bantybanty/ESP8266-Deskop_Power/Project Outputs for ESP8266-Deskop_Power/Verification Report/DiffReport/ESP8266-Deskop_Power.html

Altium

# Differences Report for Project ESP8266-Deskop_Power.PrjPcb and ESP8266-Deskop_Power.PcbDoc

Date: | | 26-12-2024
Time: | | 17:57:14
Filename: | | C:\Users\desktop\Documents\Project Files\Altium\Projects\Project - Devlopment\ESP8266-Deskop_Power\Project Outputs for ESP8266-Deskop_Power\Verification Report\DiffReport\ESP8266-Deskop_Power.html

## Different Descriptions

Schematic Object | PCB Object
MM3Z12VST1G Zener Diode, 12V 2% 200 mW SMT 2-Pin SOD-323 | ON Semiconductor MM3Z12VST1G [ZD1P]

Back to top
