bantybanty/ESP8266-Deskop_Power/Project Outputs for ESP8266-Deskop_Power/Full Documentation/ERC/Electrical Rules Check.PDF

### Electrical Rules Check Report

Class | Document | Message
Warning | 5_Keys_And_Status.SchDoc | Net WS2812B_DATA has no driving source (Pin LED1K-4, Pin R3K-1)
Thursday 26 Dec 2024 6:30:08 PM | Page 1 of 1
