bantybanty/ESP8266-Deskop_Power/screenshot/Screenshot_1.png

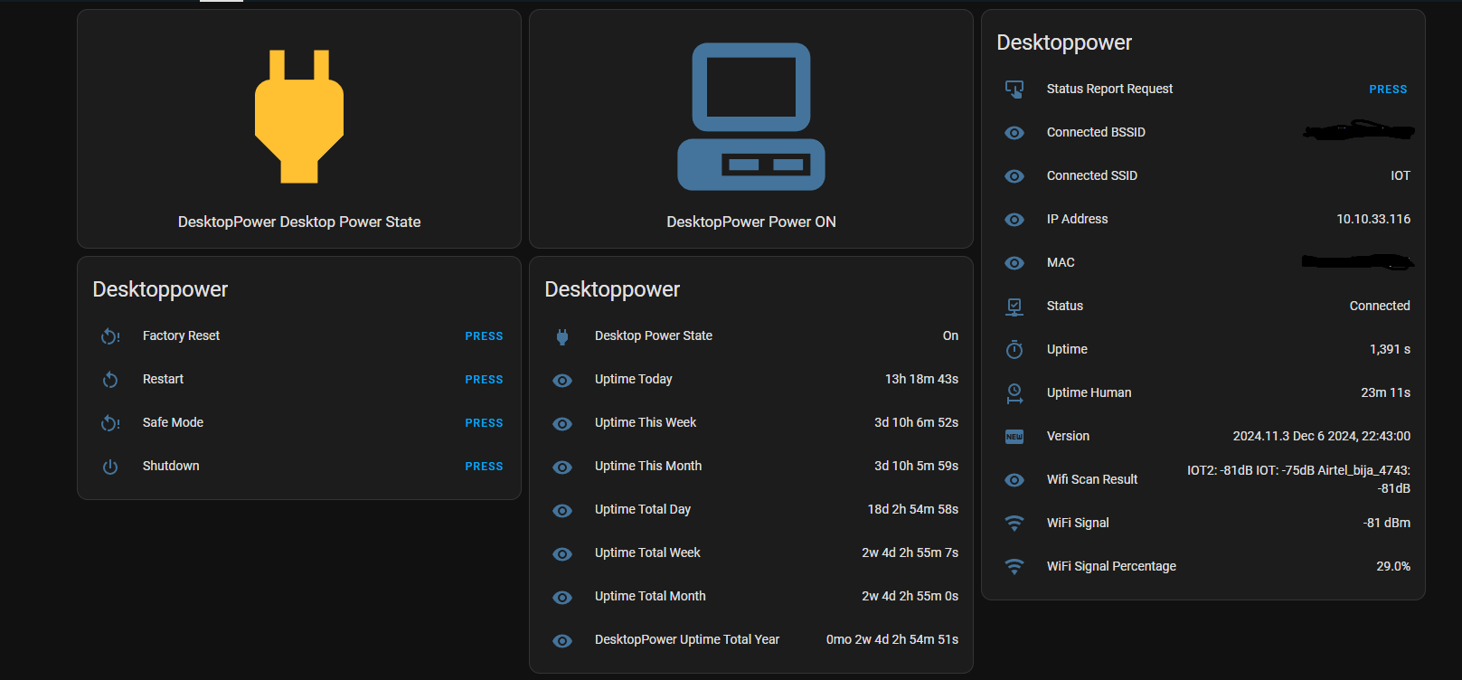
screenshot/Screenshot_1.png
