bantybanty/ESP8266-Deskop_Power/Project Outputs for ESP8266-Deskop_Power/Full Documentation/BOM/Bill of Materials.PDF

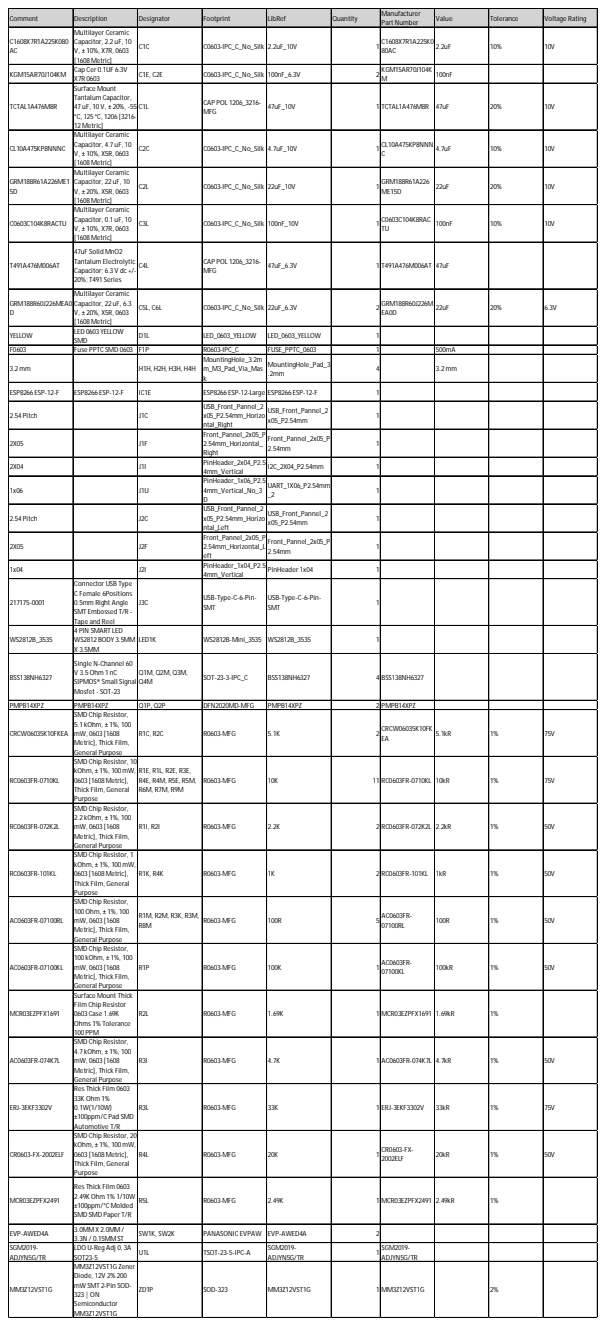
[picture p2: page 1]

Comment | Description | Designator | Footprint | LibRef | Quantity | Manufacturer Part Number | Value | Tolerance | Voltage Rating

C1608X7R1A225K080 AC | Multilayer Ceramic Capacitor, 2.2 uF, 10 V, ± 10%, X7R, 0603 [1608 Metric] | C1C | C0603-IPC_C_No_Silk | 2.2uF_10V | | 1 C1608X7R1A225K0 80AC | 2.2uF | 10% | 10V

KGM15AR70J104KM | Cap Cer 0.1UF 6.3V X7R 0603 | C1E, C2E | C0603-IPC_C_No_Silk | 100nF_6.3V | | 2 KGM15AR70J104K M | 100nF

TCTAL1A476M8R | Surface Mount Tantalum Capacitor, 47 uF, 10 V, ± 20%, -55 °C, 125 °C, 1206 [3216-12 Metric] | C1L | CAP POL 1206_3216-MFG | 47uF_10V | | 1 TCTAL1A476M8R | 47uF | 20% | 10V

CL10A475KP8NNNC | Multilayer Ceramic Capacitor, 4.7 uF, 10 V, ± 10%, X5R, 0603 [1608 Metric] | C2C | C0603-IPC_C_No_Silk | 4.7uF_10V | | 1 CL10A475KP8NNN C | 4.7uF | 10% | 10V

GRM188R61A226ME1 5D | Multilayer Ceramic Capacitor, 22 uF, 10 V, ± 20%, X5R, 0603 [1608 Metric] | C2L | C0603-IPC_C_No_Silk | 22uF_10V | | 1 GRM188R61A226 ME15D | 22uF | 20% | 10V

C0603C104K8RACTU | Multilayer Ceramic Capacitor, 0.1 uF, 10 V, ± 10%, X7R, 0603 [1608 Metric] | C3L | C0603-IPC_C_No_Silk | 100nF_10V | | 1 C0603C104K8RAC TU | 100nF | 10% | 10V

T491A476M006AT | 47uF Solid MnO2 Tantalum Electrolytic Capacitor; 6.3 V dc +/-20%; T491 Series | C4L | CAP POL 1206_3216-MFG | 47uF_6.3V | | 1 T491A476M006AT | 47uF

GRM188R60J226MEA0 D | Multilayer Ceramic Capacitor, 22 uF, 6.3 V, ± 20%, X5R, 0603 [1608 Metric] | C5L, C6L | C0603-IPC_C_No_Silk | 22uF_6.3V | | 2 GRM188R60J226M EA0D | 22uF | 20% | 6.3V

YELLOW | LED 0603 YELLOW SMD | D1L | LED_0603_YELLOW | LED_0603_YELLOW | | 1

F0603 | Fuse PPTC SMD 0603 | F1P | R0603-IPC_C | FUSE_PPTC_0603 | | 1 | 500mA
3.2mm | | H1H, H2H, H3H, H4H | MountingHole_3.2m m_M3_Pad_Via_Mas k | MountingHole_Pad_3 .2mm | | 4 | 3.2mm

ESP8266 ESP-12-F | ESP8266 ESP-12-F | IC1E | ESP8266 ESP-12-Large | ESP8266 ESP-12-F | | 1

2.54 Pitch | | J1C | USB_Front_Pannel_2 x05_P2.54mm_Horizo ntal_Right | USB_Front_Pannel_2 x05_P2.54mm | | 1

2X05 | | J1F | Front_Pannel_2x05_P 2.54mm_Horizontal_ Right | Front_Pannel_2x05_P 2.54mm | | 1

2X04 | | J1I | PinHeader_2x04_P2.5 4mm_Vertical | I2C_2X04_P2.54mm | | 1

1x06 | | J1U | PinHeader_1x06_P2.5 4mm_Vertical_No_3 D | UART_1X06_P2.54mm _2 | | 1

2.54 Pitch | | J2C | USB_Front_Pannel_2 x05_P2.54mm_Horizo ntal_Left | USB_Front_Pannel_2 x05_P2.54mm | | 1

2X05 | | J2F | Front_Pannel_2x05_P 2.54mm_Horizontal_L eft | Front_Pannel_2x05_P 2.54mm | | 1

1x04 | | J2I | PinHeader_1x04_P2.5 4mm_Vertical | PinHeader 1x04 | | 1

217175-0001 | Connector USB Type C Female 6Positions 0.5mm Right Angle SMT Embossed T/R -Tape and Reel | J3C | USB-Type-C-6-Pin-SMT | USB-Type-C-6-Pin-SMT | | 1

WS2812B_3535 | 4 PIN SMART LED WS2812 BODY 3.5MM X 3.5MM | LED1K | WS2812B-Mini_3535 | WS2812B_3535 | | 1

BSS138NH6327 | Single N-Channel 60 V 3.5Ohm 1 nC SIPMOS® Small Signal Mosfet - SOT-23 | Q1M, Q2M, Q3M, Q4M | SOT-23-3-IPC_C | BSS138NH6327 | | 4 BSS138NH6327

PMPB14XPZ | PMPB14XPZ | Q1P, Q2P | DFN2020MD-MFG | PMPB14XPZ | | 2 PMPB14XPZ
CRCW06035K10FKEA | SMD Chip Resistor, 5.1 kOhm, ± 1%, 100 mW, 0603 [1608 Metric], Thick Film, General Purpose | R1C, R2C | R0603-MFG | 5.1K | | 2 CRCW06035K10FK EA | 5.1kR | 1% | 75V

RC0603FR-0710KL | SMD Chip Resistor, 10 kOhm, ± 1%, 100mW, 0603 [1608 Metric], Thick Film, General Purpose | R1E, R1L, R2E, R3E, R4E, R4M, R5E, R5M, R6M, R7M, R9M | R0603-MFG | 10K | 11 RC0603FR-0710KL | | 10kR | 1% | 75V

RC0603FR-072K2L | SMD Chip Resistor, 2.2 kOhm, ± 1%, 100 mW, 0603 [1608 Metric], Thick Film, General Purpose | R1I, R2I | R0603-MFG | 2.2K | | 2 RC0603FR-072K2L | 2.2kR | 1% | 50V

RC0603FR-101KL | SMD Chip Resistor, 1 kOhm, ± 1%, 100mW, 0603 [1608 Metric], Thick Film, General Purpose | R1K, R4K | R0603-MFG | 1K | | 2 RC0603FR-101KL | 1kR | 1% | 50V

AC0603FR-07100RL | SMD Chip Resistor, 100Ohm, ± 1%, 100 mW, 0603 [1608 Metric], Thick Film, General Purpose | R1M, R2M, R3K, R3M, R8M | R0603-MFG | 100R | | 5 AC0603FR-07100RL | 100R | 1% | 50V

AC0603FR-07100KL | SMD Chip Resistor, 100 kOhm, ± 1%, 100 mW, 0603 [1608 Metric], Thick Film, General Purpose | R1P | R0603-MFG | 100K | | 1 AC0603FR-07100KL | 100kR | 1% | 50V

MCR03EZPFX1691 | Surface Mount Thick Film Chip Resistor 0603 Case 1.69K Ohms 1% Tolerance 100 PPM | R2L | R0603-MFG | 1.69K | | 1 MCR03EZPFX1691 | 1.69kR | 1%

AC0603FR-074K7L | SMD Chip Resistor, 4.7 kOhm, ± 1%, 100 mW, 0603 [1608 Metric], Thick Film, General Purpose | R3I | R0603-MFG | 4.7K | | 1 AC0603FR-074K7L | 4.7kR | 1% | 50V

ERJ-3EKF3302V | Res Thick Film 0603 33K Ohm 1% 0.1W(1/10W) ±100ppm/C Pad SMD Automotive T/R | R3L | R0603-MFG | 33K | | 1 ERJ-3EKF3302V | 33kR | 1% | 75V

CR0603-FX-2002ELF | SMD Chip Resistor, 20 kOhm, ± 1%, 100mW, 0603 [1608 Metric], Thick Film, General Purpose | R4L | R0603-MFG | 20K | | 1 CR0603-FX-2002ELF | 20kR | 1% | 50V

MCR03EZPFX2491 | Res Thick Film 0603 2.49K Ohm 1% 1/10W ±100ppm/°C Molded SMD SMD Paper T/R | R5L | R0603-MFG | 2.49K | | 1 MCR03EZPFX2491 | 2.49kR | 1%

EVP-AWED4A | 3.0MM X 2.0MM / 3.3N / 0.15MM ST | SW1K, SW2K | PANASONIC EVPAW | EVP-AWED4A | | 2

SGM2019-ADJYN5G/TR | LDO U-Reg Adj 0, 3A SOT23-5 | U1L | TSOT-23-5-IPC-A | SGM2019-ADJYN5G/TR | | 1 SGM2019-ADJYN5G/TR

MM3Z12VST1G | MM3Z12VST1G Zener Diode, 12V 2% 200 mW SMT 2-Pin SOD-323 | ON Semiconductor MM3Z12VST1G | ZD1P | SOD-323 | MM3Z12VST1G | | 1 MM3Z12VST1G | | 2%
