bantybanty/ESP8266-Deskop_Power/Project Outputs for ESP8266-Deskop_Power/Verification Report/ReportComponents/Component Cross Reference Report-ESP8266-Deskop_Power.xlsx

Comment | Description | Designator | Footprint | LibRef | Quantity
F0603, PMPB14XPZ, AC0603FR-07100KL, MM3Z12VST1G | Fuse PPTC SMD 0603, PMPB14XPZ, SMD Chip Resistor, 100 kOhm, ± 1%, 100 mW, 0603 [1608 Metric], Thick Film, General Purpose, MM3Z12VST1G Zener Diode, 12V 2% 200 mW SMT 2-Pin SOD-323 | ON Semiconductor MM3Z12VST1G | F1P, Q1P, Q2P, R1P, ZD1P | R0603-IPC_C, DFN2020MD-MFG, R0603-MFG, SOD-323 | FUSE_PPTC_0603, PMPB14XPZ, 100K, MM3Z12VST1G | 5
TCTAL1A476M8R, GRM188R61A226ME15D, C0603C104K8RACTU, T491A476M006AT, GRM188R60J226MEA0D, YELLOW, RC0603FR-0710KL, MCR03EZPFX1691, ERJ-3EKF3302V, CR0603-FX-2002ELF, MCR03EZPFX2491, SGM2019-ADJYN5G/TR | Surface Mount Tantalum Capacitor, 47 uF, 10 V, ± 20%, -55 °C, 125 °C, 1206 [3216-12 Metric], Multilayer Ceramic Capacitor, 22 uF, 10 V, ± 20%, X5R, 0603 [1608 Metric], Multilayer Ceramic Capacitor, 0.1 uF, 10 V, ± 10%, X7R, 0603 [1608 Metric], 47uF Solid MnO2 Tantalum Electrolytic Capacitor; 6.3 V dc +/-20%; T491 Series, Multilayer Ceramic Capacitor, 22 uF, 6.3 V, ± 20%, X5R, 0603 [1608 Metric], LED 0603 YELLOW SMD, SMD Chip Resistor, 10 kOhm, ± 1%, 100 mW, 0603 [1608 Metric], Thick Film, General Purpose, Surface Mount Thick Film Chip Resistor 0603 Case 1.69K Ohms 1% Tolerance 100 PPM, Res Thick Film 0603 33K Ohm 1% 0.1W(1/10W) ±100ppm/C Pad SMD Automotive T/R, SMD Chip Resistor, 20 kOhm, ± 1%, 100 mW, 0603 [1608 Metric], Thick Film, General Purpose, Res Thick Film 0603 2.49K Ohm 1% 1/10W ±100ppm/°C Molded SMD SMD Paper T/R, LDO U-Reg Adj 0, 3A SOT23-5 | C1L, C2L, C3L, C4L, C5L, C6L, D1L, R1L, R2L, R3L, R4L, R5L, U1L | CAP POL 1206_3216-MFG, C0603-IPC_C_No_Silk, LED_0603_YELLOW, R0603-MFG, TSOT-23-5-IPC-A | 47uF_10V, 22uF_10V, 100nF_10V, 47uF_6.3V, 22uF_6.3V, LED_0603_YELLOW, 10K, 1.69K, 33K, 20K, 2.49K, SGM2019-ADJYN5G/TR | 13
KGM15AR70J104KM, ESP8266 ESP-12-F, RC0603FR-0710KL | Cap Cer 0.1UF 6.3V X7R 0603, ESP8266 ESP-12-F, SMD Chip Resistor, 10 kOhm, ± 1%, 100 mW, 0603 [1608 Metric], Thick Film, General Purpose | C1E, C2E, IC1E, R1E, R2E, R3E, R4E, R5E | C0603-IPC_C_No_Silk, ESP8266 ESP-12-Large, R0603-MFG | 100nF_6.3V, ESP8266 ESP-12-F, 10K | 8
1x06 |  | J1U | PinHeader_1x06_P2.54mm_Vertical_No_3D | UART_1X06_P2.54mm_2 | 1
WS2812B_3535, RC0603FR-101KL, AC0603FR-07100RL, EVP-AWED4A | 4 PIN SMART LED WS2812 BODY 3.5MM X 3.5MM, SMD Chip Resistor, 1 kOhm, ± 1%, 100 mW, 0603 [1608 Metric], Thick Film, General Purpose, SMD Chip Resistor, 100 Ohm, ± 1%, 100 mW, 0603 [1608 Metric], Thick Film, General Purpose, 3.0MM X 2.0MM / 3.3N / 0.15MM ST | LED1K, R1K, R3K, R4K, SW1K, SW2K | WS2812B-Mini_3535, R0603-MFG, PANASONIC EVPAW | WS2812B_3535, 1K, 100R, EVP-AWED4A | 6
2X04, 1x04, RC0603FR-072K2L, AC0603FR-074K7L | [NoValue], SMD Chip Resistor, 2.2 kOhm, ± 1%, 100 mW, 0603 [1608 Metric], Thick Film, General Purpose, SMD Chip Resistor, 4.7 kOhm, ± 1%, 100 mW, 0603 [1608 Metric], Thick Film, General Purpose | J1I, J2I, R1I, R2I, R3I | PinHeader_2x04_P2.54mm_Vertical, PinHeader_1x04_P2.54mm_Vertical, R0603-MFG | I2C_2X04_P2.54mm, PinHeader 1x04, 2.2K, 4.7K | 5
BSS138NH6327, AC0603FR-07100RL, RC0603FR-0710KL | Single N-Channel 60 V 3.5 Ohm 1 nC SIPMOS® Small Signal Mosfet - SOT-23, SMD Chip Resistor, 100 Ohm, ± 1%, 100 mW, 0603 [1608 Metric], Thick Film, General Purpose, SMD Chip Resistor, 10 kOhm, ± 1%, 100 mW, 0603 [1608 Metric], Thick Film, General Purpose | Q1M, Q2M, Q3M, Q4M, R1M, R2M, R3M, R4M, R5M, R6M, R7M, R8M, R9M | SOT-23-3-IPC_C, R0603-MFG | BSS138NH6327, 100R, 10K | 13
2X05 |  | J1F, J2F | Front_Pannel_2x05_P2.54mm_Horizontal_Right, Front_Pannel_2x05_P2.54mm_Horizontal_Left | Front_Pannel_2x05_P2.54mm | 2
C1608X7R1A225K080AC, CL10A475KP8NNNC, 2.54 Pitch, 217175-0001, CRCW06035K10FKEA | Multilayer Ceramic Capacitor, 2.2 uF, 10 V, ± 10%, X7R, 0603 [1608 Metric], Multilayer Ceramic Capacitor, 4.7 uF, 10 V, ± 10%, X5R, 0603 [1608 Metric], [NoValue], Connector USB Type C Female 6Positions 0.5mm Right Angle SMT Embossed T/R - Tape and Reel, SMD Chip Resistor, 5.1 kOhm, ± 1%, 100 mW, 0603 [1608 Metric], Thick Film, General Purpose | C1C, C2C, J1C, J2C, J3C, R1C, R2C | C0603-IPC_C_No_Silk, USB_Front_Pannel_2x05_P2.54mm_Horizontal_Right, USB_Front_Pannel_2x05_P2.54mm_Horizontal_Left, USB-Type-C-6-Pin-SMT, R0603-MFG | 2.2uF_10V, 4.7uF_10V, USB_Front_Pannel_2x05_P2.54mm, USB-Type-C-6-Pin-SMT, 5.1K | 7
3.2 mm |  | H1H, H2H, H3H, H4H | MountingHole_3.2mm_M3_Pad_Via_Mask | MountingHole_Pad_3.2mm | 4
