bantybanty/ESP8266-Deskop_Power/Project Outputs for ESP8266-Deskop_Power/Full Documentation/PCBDrawing/Assembly Drawing.PDF

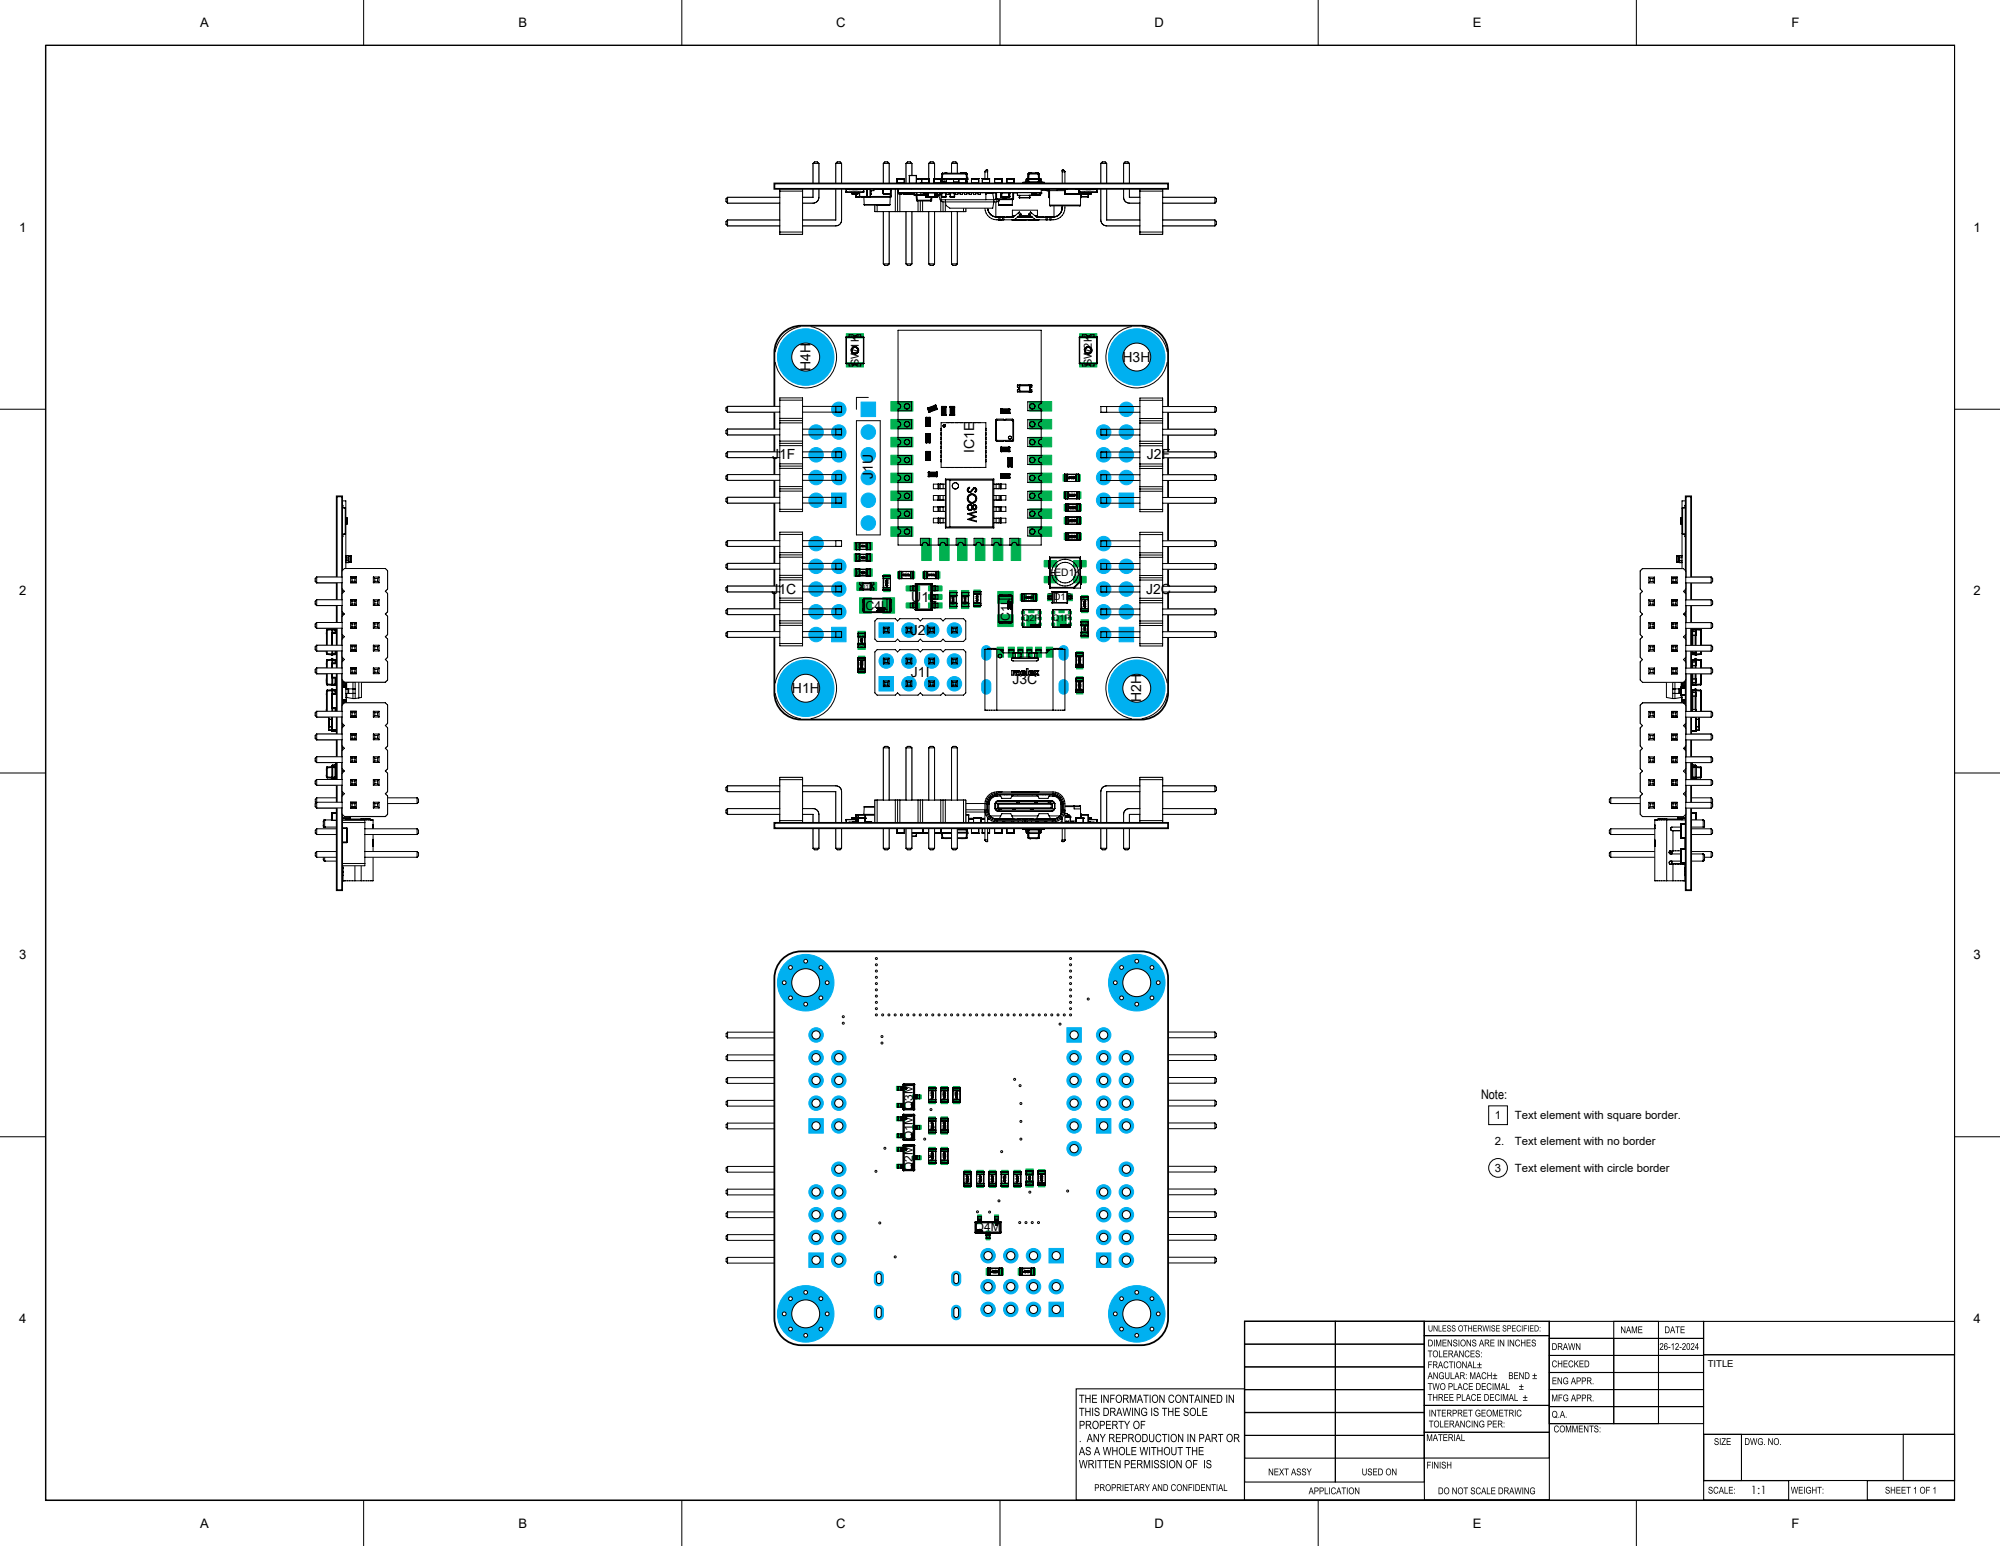
[picture p3: page 1]

Note:
1 Text element with square border.

2. Text element with no border

3 Text element with circle border

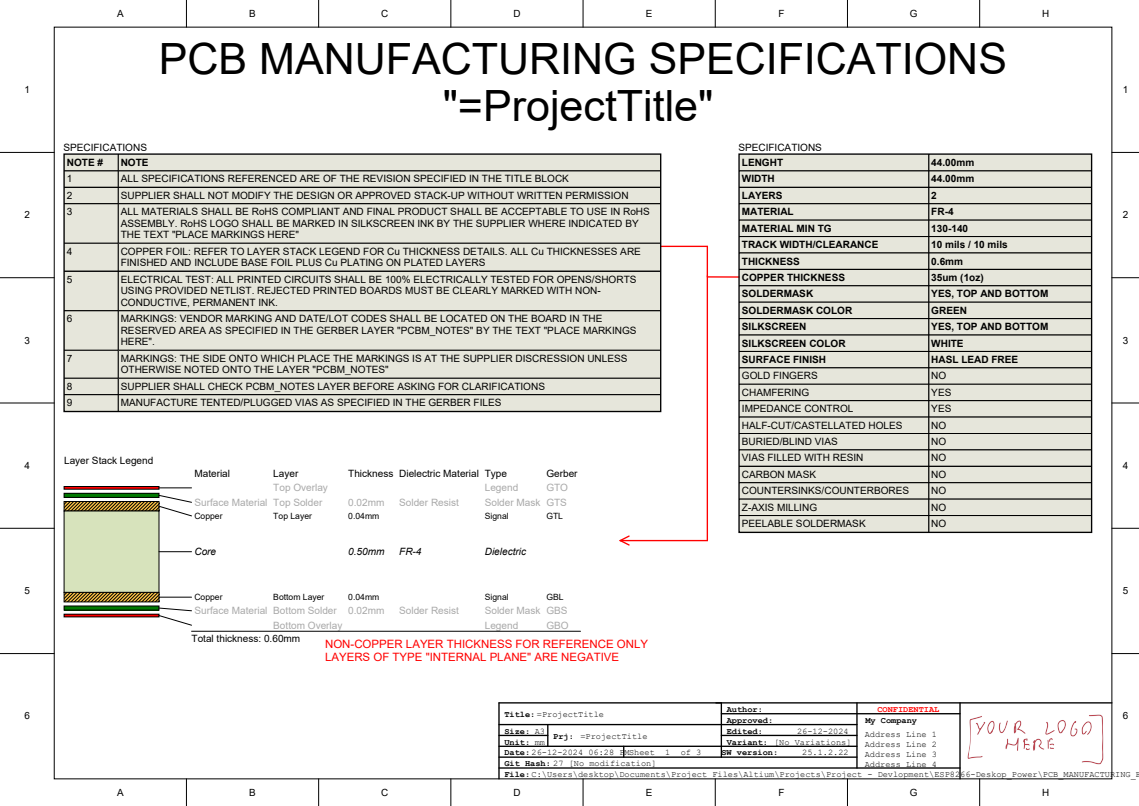
[picture p4: page 2]

NOTE
ALL SPECIFICATIONS REFERENCED ARE OF THE REVISION SPECIFIED IN THE TITLE BLOCK
SUPPLIER SHALL NOT MODIFY THE DESIGN OR APPROVED STACK-UP WITHOUT WRITTEN PERMISSION
ALL MATERIALS SHALL BE RoHS COMPLIANT AND FINAL PRODUCT SHALL BE ACCEPTABLE TO USE IN RoHS
ASSEMBLY. RoHS LOGO SHALL BE MARKED IN SILKSCREEN INK BY THE SUPPLIER WHERE INDICATED BY
THE TEXT "PLACE MARKINGS HERE"

MATERIAL MIN TG | 130-140
TRACK WIDTH/CLEARANCE | 10 mils / 10 mils
THICKNESS | 0.6mm

4 | COPPER FOIL: REFER TO LAYER STACK LEGEND FOR Cu THICKNESS DETAILS. ALL Cu THICKNESSES ARE FINISHED AND INCLUDE BASE FOIL PLUS Cu PLATING ON PLATED LAYERS

ELECTRICAL TEST: ALL PRINTED CIRCUITS SHALL BE 100% ELECTRICALLY TESTED FOR OPENS/SHORTS
USING PROVIDED NETLIST. REJECTED PRINTED BOARDS MUST BE CLEARLY MARKED WITH NON-
CONDUCTIVE, PERMANENT INK.

SOLDERMASK | YES, TOP AND BOTTOM
SOLDERMASK COLOR | GREEN
SILKSCREEN | YES, TOP AND BOTTOM
SILKSCREEN COLOR | WHITE

6 | MARKINGS: VENDOR MARKING AND DATE/LOT CODES SHALL BE LOCATED ON THE BOARD IN THE RESERVED AREA AS SPECIFIED IN THE GERBER LAYER "PCBM_NOTES" BY THE TEXT "PLACE MARKINGS HERE".

MARKINGS: THE SIDE ONTO WHICH PLACE THE MARKINGS IS AT THE SUPPLIER DISCRESSION UNLESS
OTHERWISE NOTED ONTO THE LAYER "PCBM_NOTES"

GOLD FINGERS | NO
CHAMFERING | YES
IMPEDANCE CONTROL | YES
HALF-CUT/CASTELLATED HOLES | NO
BURIED/BLIND VIAS | NO
VIAS FILLED WITH RESIN | NO
CARBON MASK | NO
COUNTERSINKS/COUNTERBORES | NO
Z-AXIS MILLING | NO
PEELABLE SOLDERMASK | NO

8 | SUPPLIER SHALL CHECK PCBM_NOTES LAYER BEFORE ASKING FOR CLARIFICATIONS
9 | MANUFACTURE TENTED/PLUGGED VIAS AS SPECIFIED IN THE GERBER FILES

NON-COPPER LAYER THICKNESS FOR REFERENCE ONLY
LAYERS OF TYPE "INTERNAL PLANE" ARE NEGATIVE

Approved: | My Company Address Line 1 Address Line 2

Size: A3 | Prj: =ProjectTitle | Edited: 26-12-2024
Unit: mm | | Variant: [No Variations]
Date:26-12-2024 06:28 PM | Sheet 1 of 3 | SW version: 25.1.2.22

Git Hash: 27 [No modification]
File:C:\Users\desktop\Documents\Project Files\Altium\Projects\Project - Devlopment\ESP8266-Deskop_Power\PCB_MANUFACTURING_ESP8266-Deskop_Power.PCBDwf

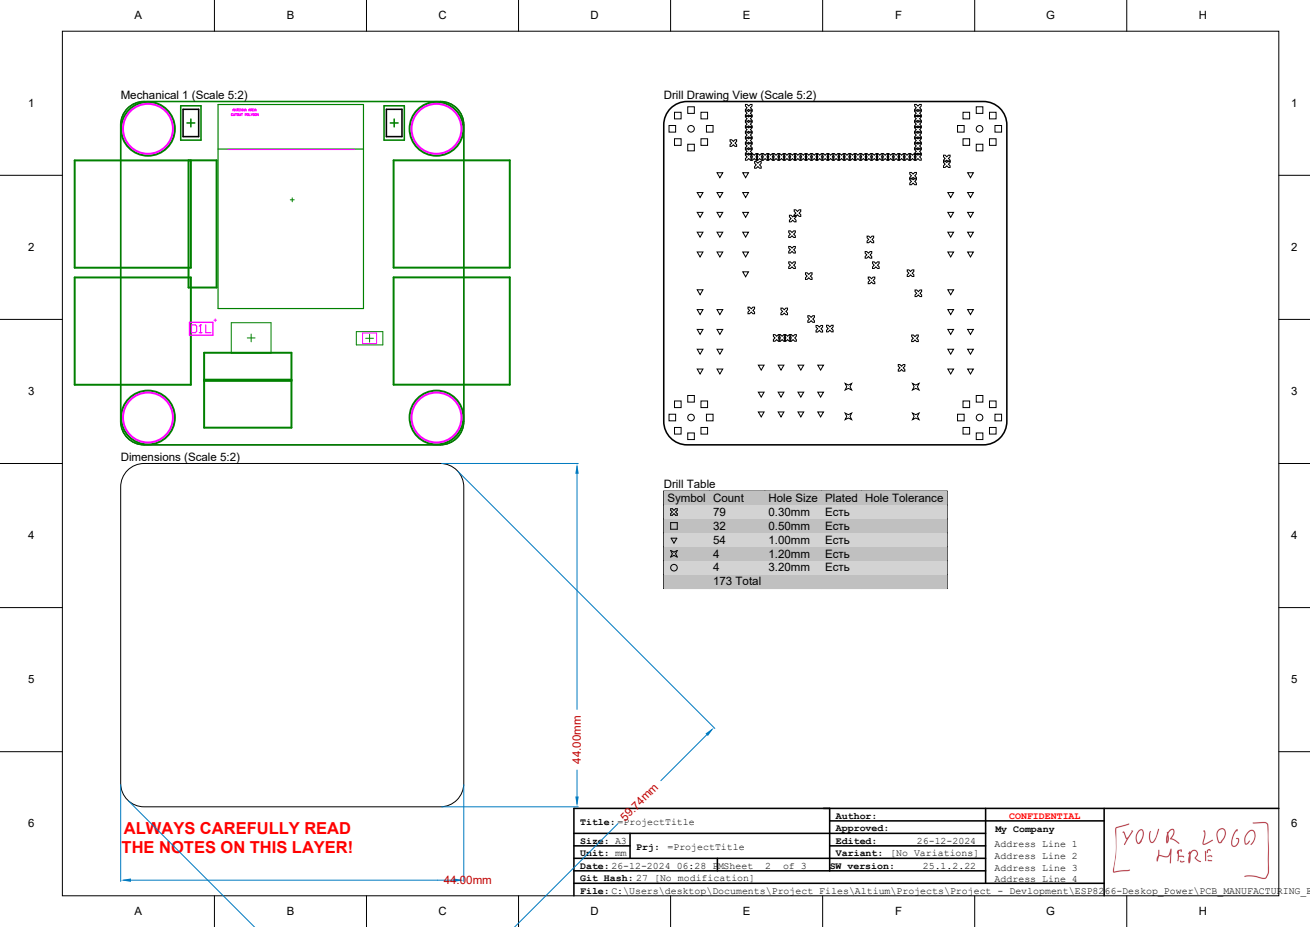
[picture p5: page 3]

Symbol | Count | Hole Size | Plated | Hole Tolerance

79 | 0.30mm | Есть
32 | 0.50mm | Есть
54 | 1.00mm | Есть
4 | 1.20mm | Есть
4 | 3.20mm | Есть
173 Total

ALWAYS CAREFULLY READ
THE NOTES ON THIS LAYER!

Approved: | My Company Address Line 1

Size: A3 | Prj: =ProjectTitle | Edited: 26-12-2024

File:C:\Users\desktop\Documents\Project Files\Altium\Projects\Project - Devlopment\ESP8266-Deskop_Power\PCB_MANUFACTURING_ESP8266-Deskop_Power.PCBDwf

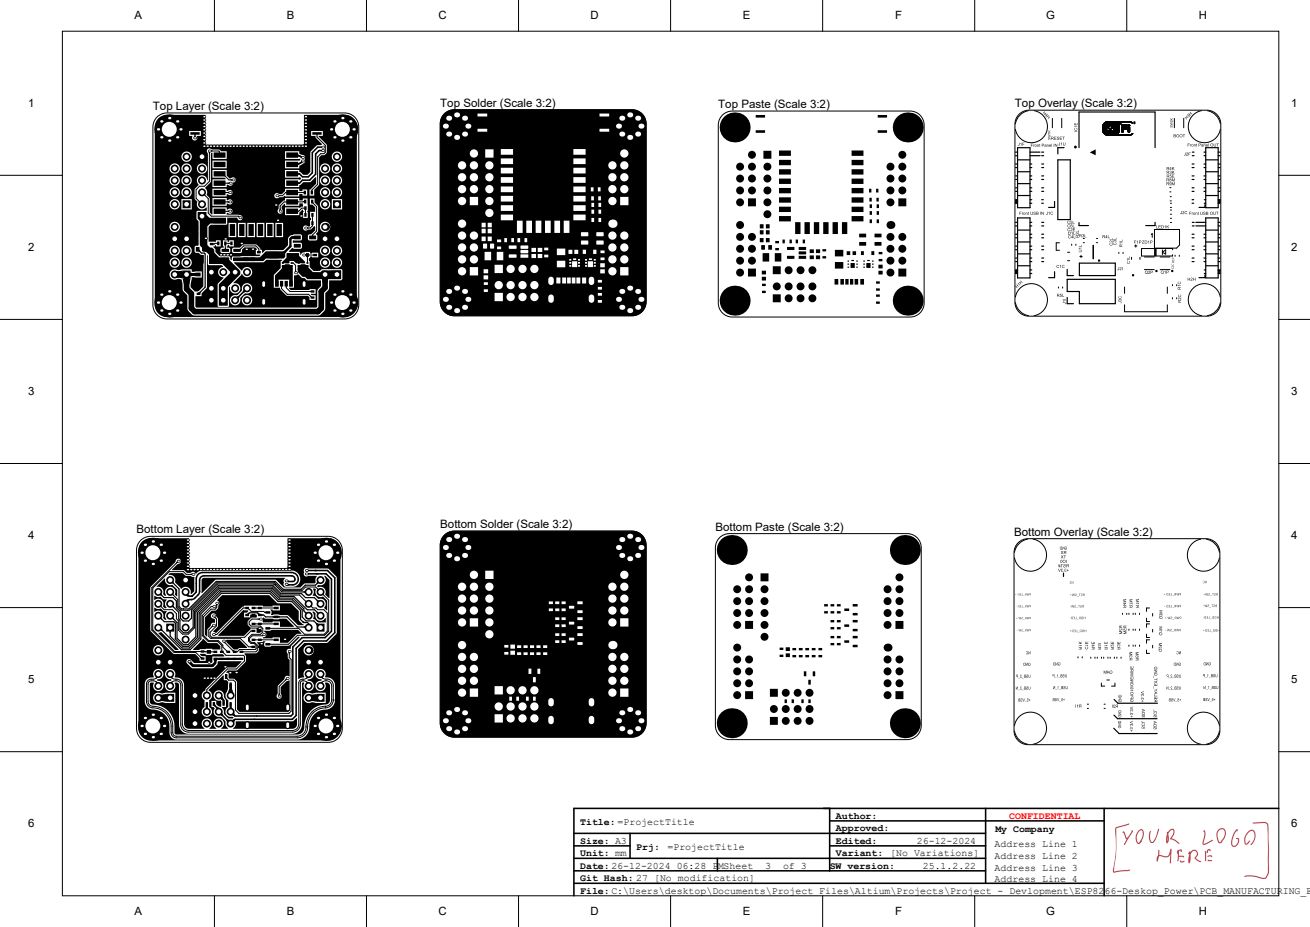
[picture p6: page 4]

File:C:\Users\desktop\Documents\Project Files\Altium\Projects\Project - Devlopment\ESP8266-Deskop_Power\PCB_MANUFACTURING_ESP8266-Deskop_Power.PCBDwf

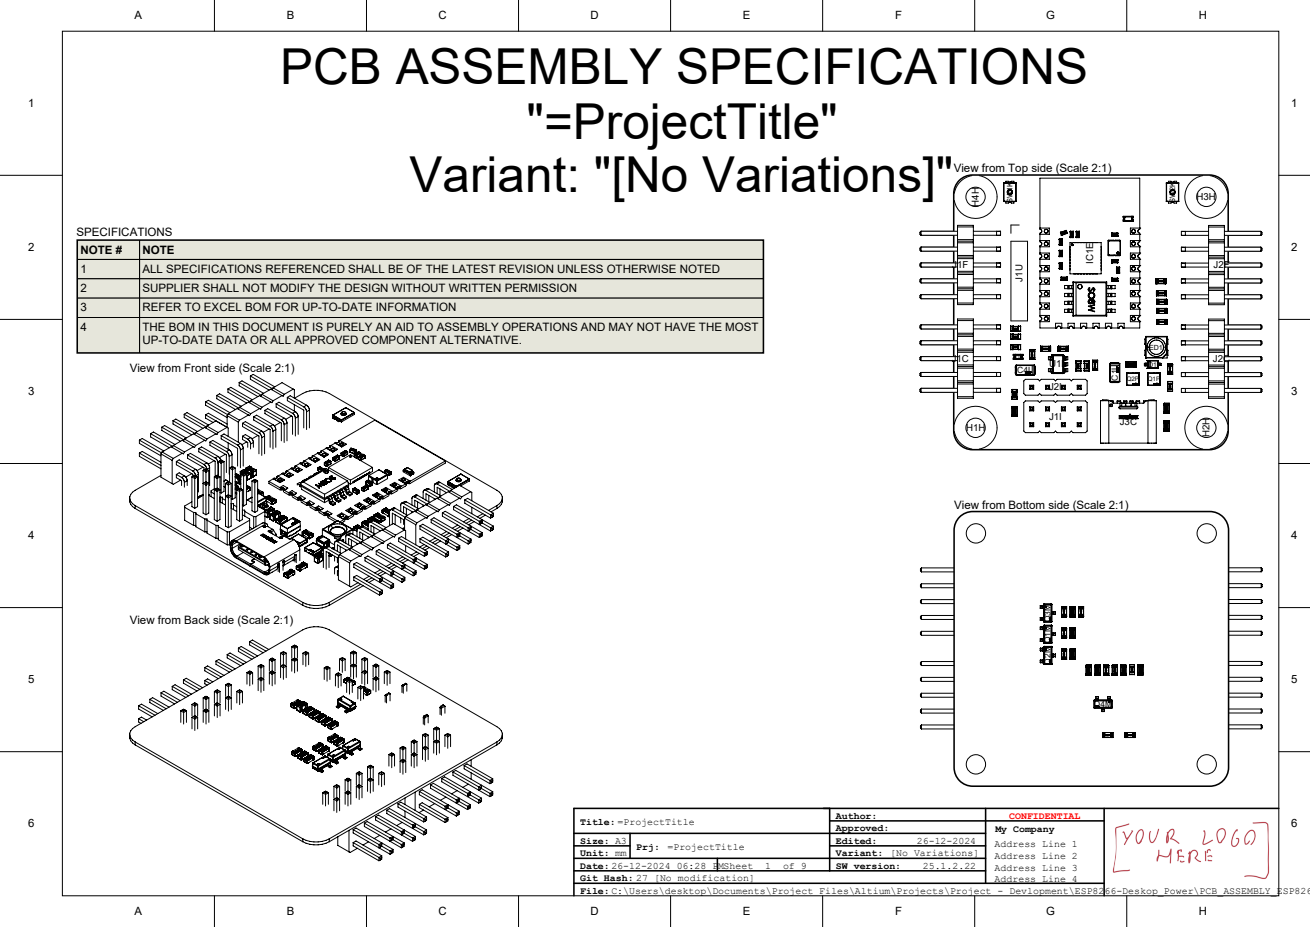
[picture p7: page 5]

View from Top side (Scale 2:1)

NOTE # | NOTE
1 | ALL SPECIFICATIONS REFERENCED SHALL BE OF THE LATEST REVISION UNLESS OTHERWISE NOTED

SUPPLIER SHALL NOT MODIFY THE DESIGN WITHOUT WRITTEN PERMISSION
REFER TO EXCEL BOM FOR UP-TO-DATE INFORMATION
THE BOM IN THIS DOCUMENT IS PURELY AN AID TO ASSEMBLY OPERATIONS AND MAY NOT HAVE THE MOST
UP-TO-DATE DATA OR ALL APPROVED COMPONENT ALTERNATIVE.

View from Front side (Scale 2:1)

View from Bottom side (Scale 2:1)

View from Back side (Scale 2:1)

Approved: | My Company Address Line 1

Size: A3 | Prj: =ProjectTitle | Edited: 26-12-2024

File:C:\Users\desktop\Documents\Project Files\Altium\Projects\Project - Devlopment\ESP8266-Deskop_Power\PCB_ASSEMBLY_ESP8266-Deskop_Power.PCBDwf

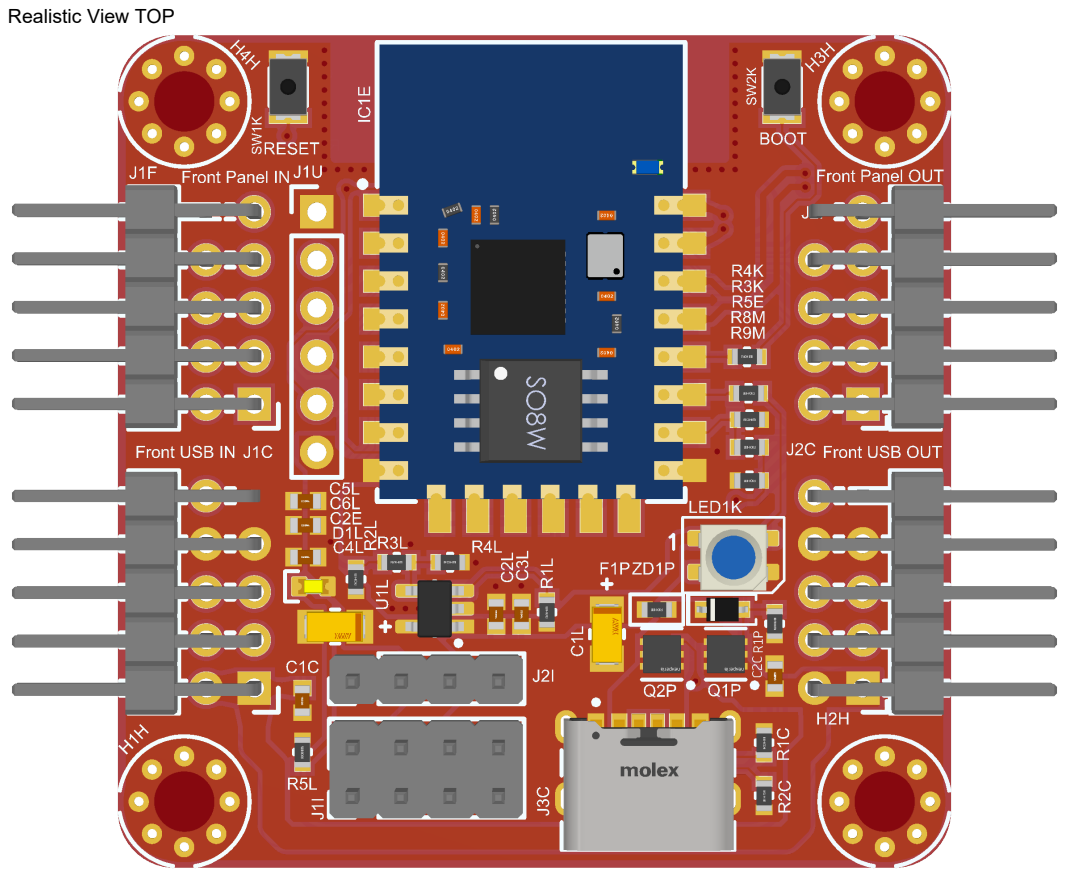
[picture p8: page 6]

Approved: | My Company Address Line 1

Size: A3 | Prj: =ProjectTitle | Edited: 26-12-2024

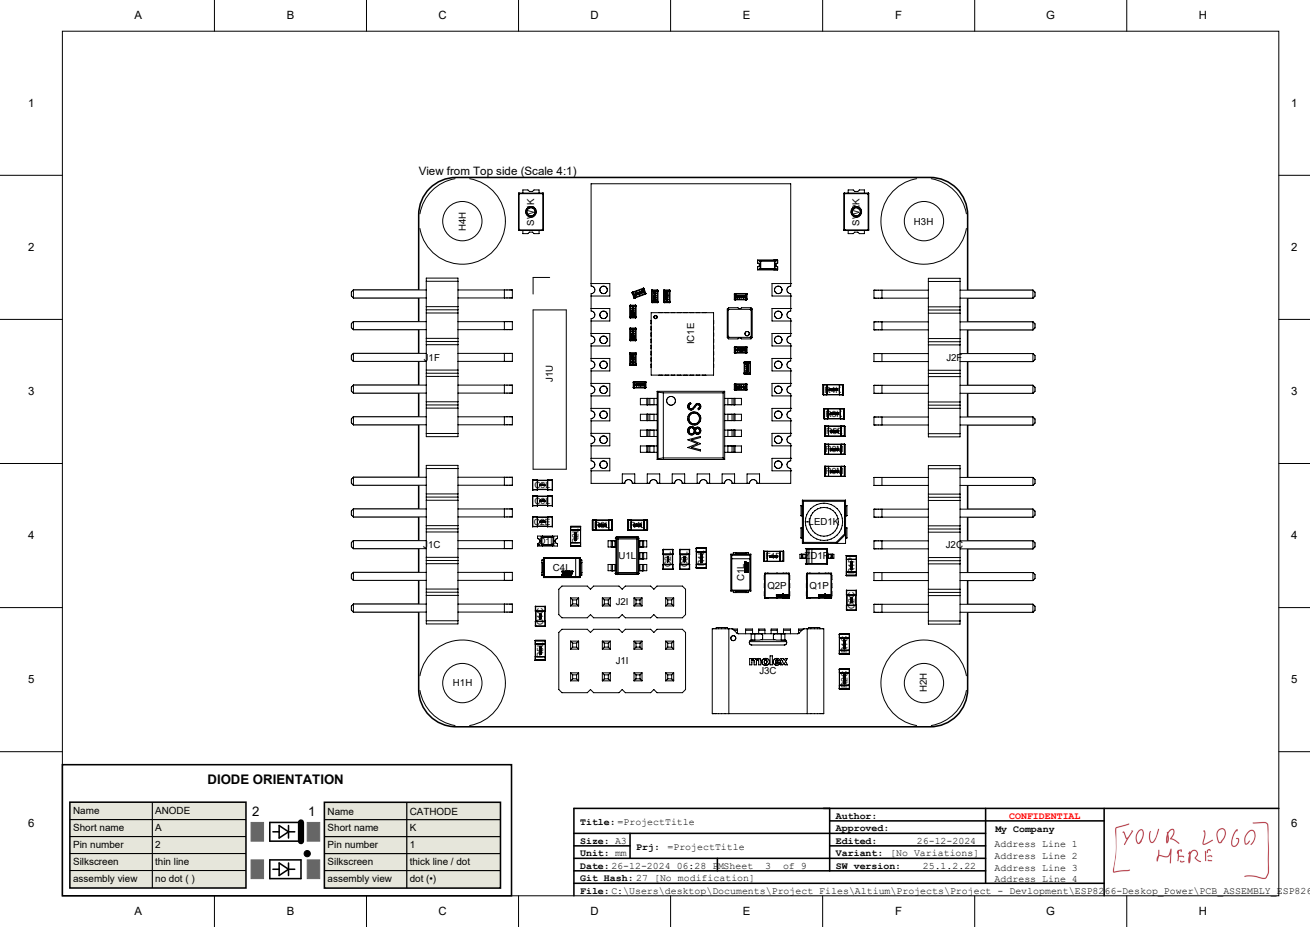
[picture p9: page 7]

View from Top side (Scale 4:1)

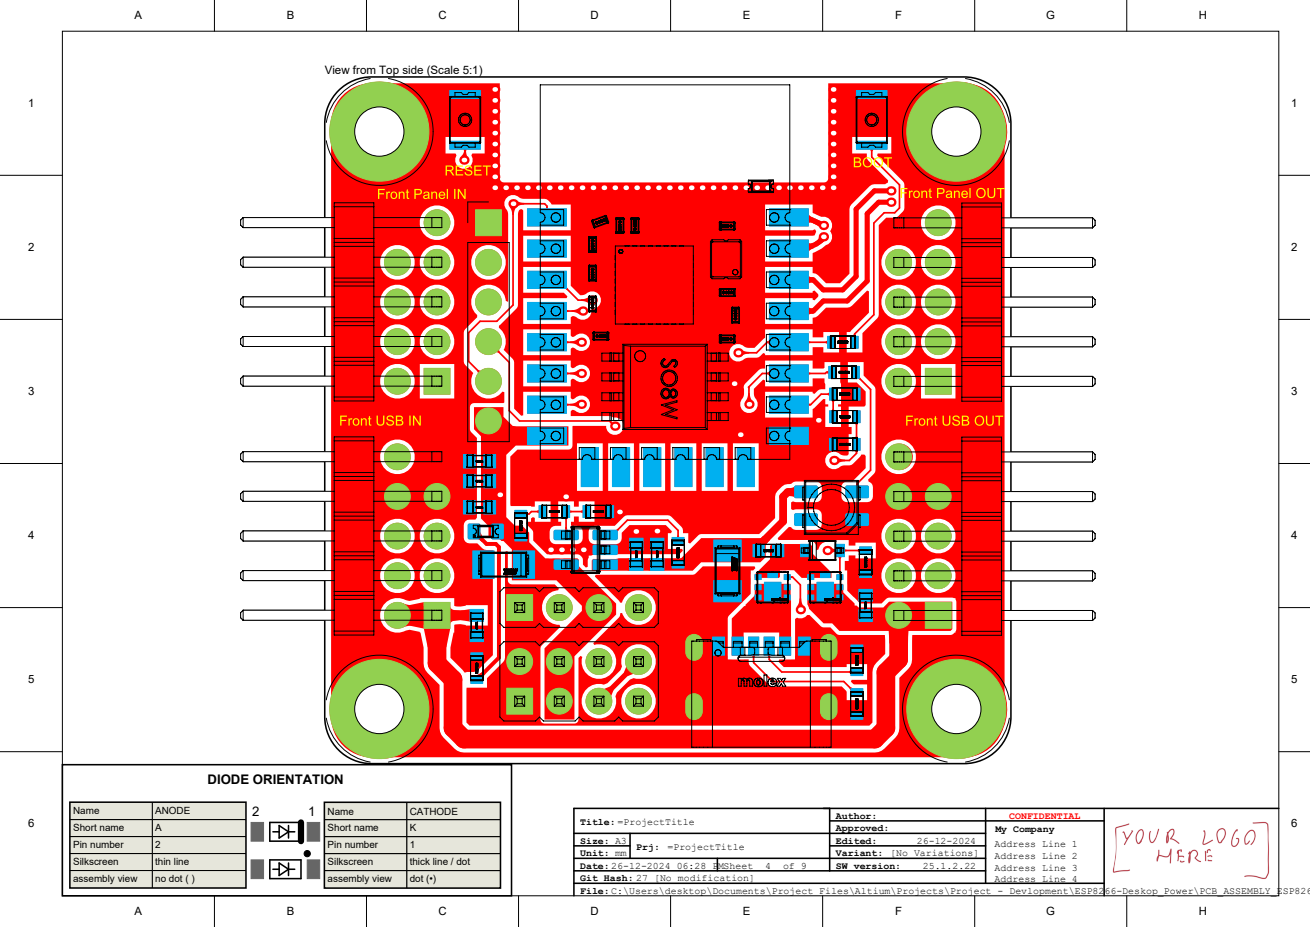
[picture p10: page 8]

View from Top side (Scale 5:1)

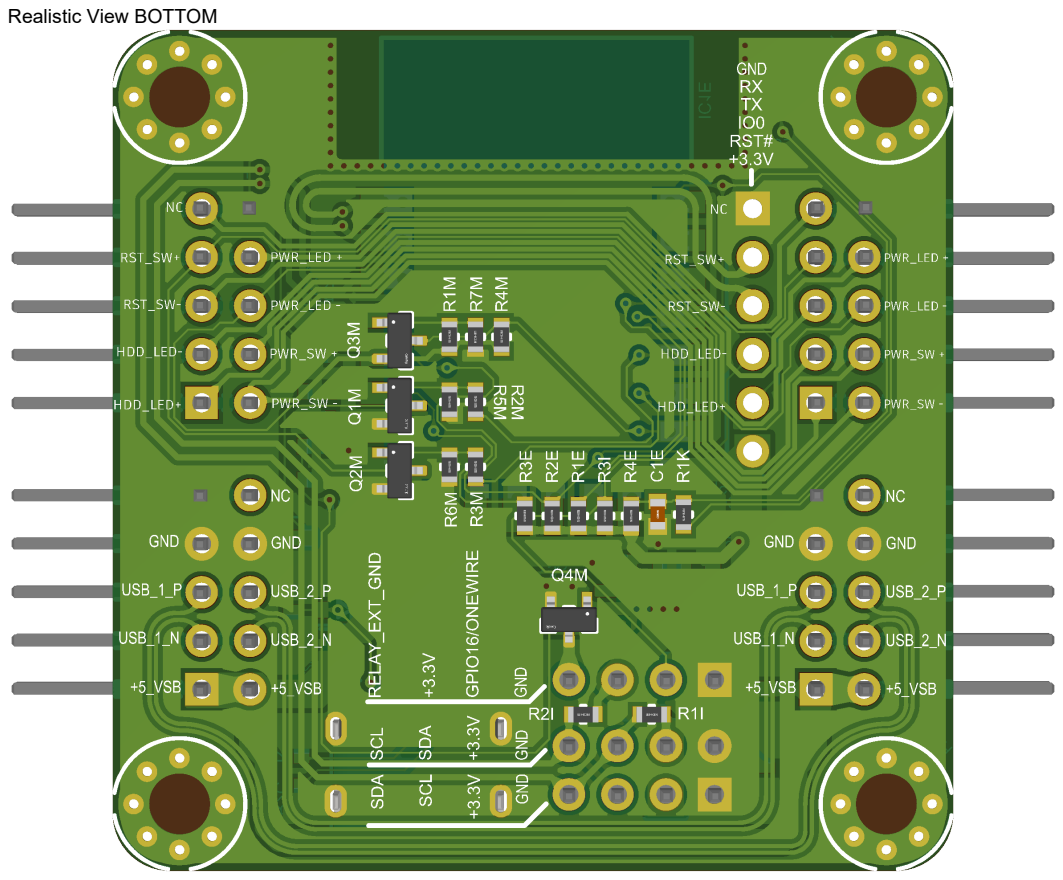
[picture p11: page 9]

Approved: | My Company Address Line 1

Size: A3 | Prj: =ProjectTitle | Edited: 26-12-2024

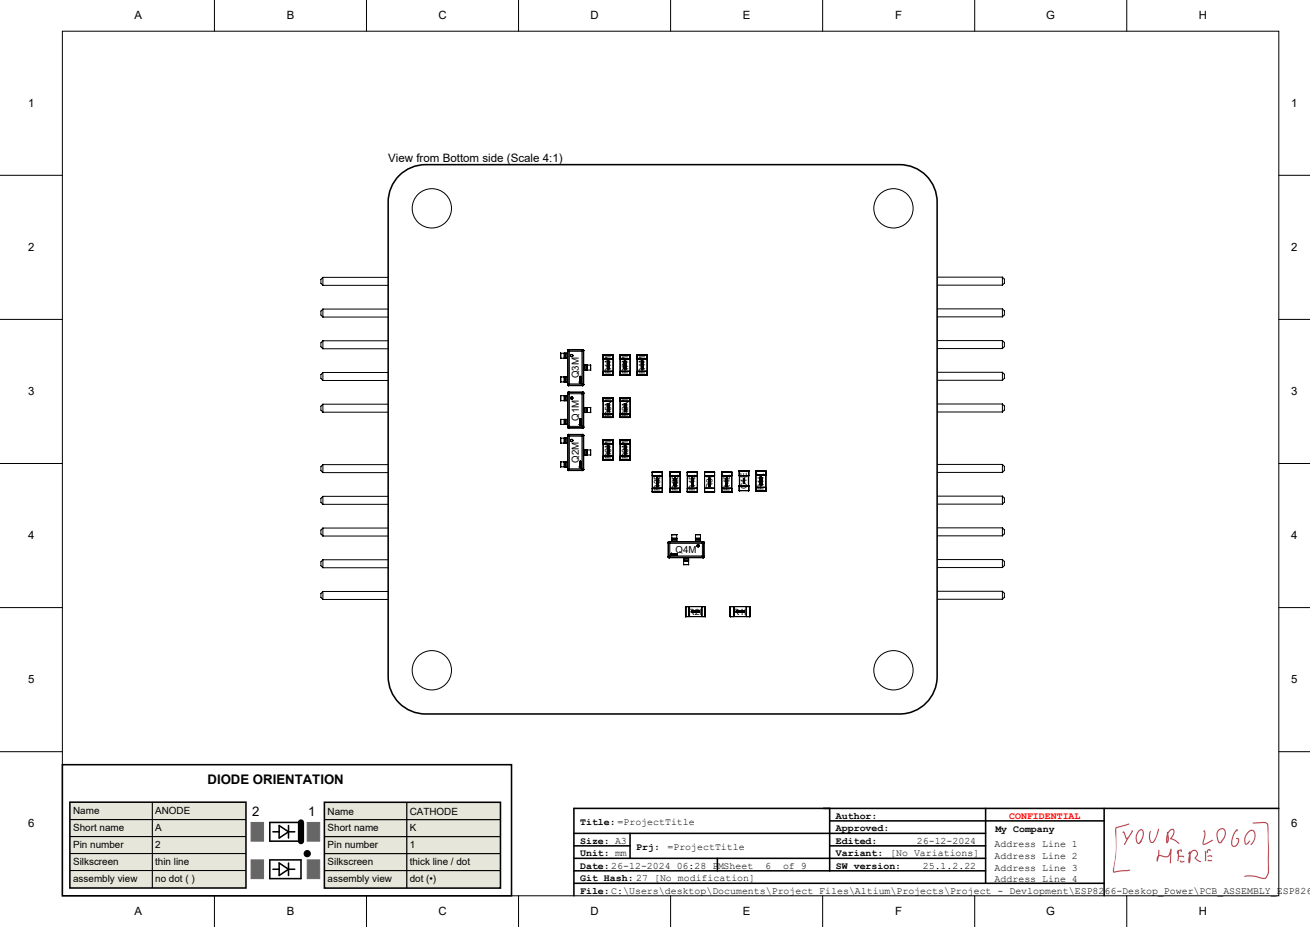
[picture p12: page 10]

View from Bottom side (Scale 4:1)

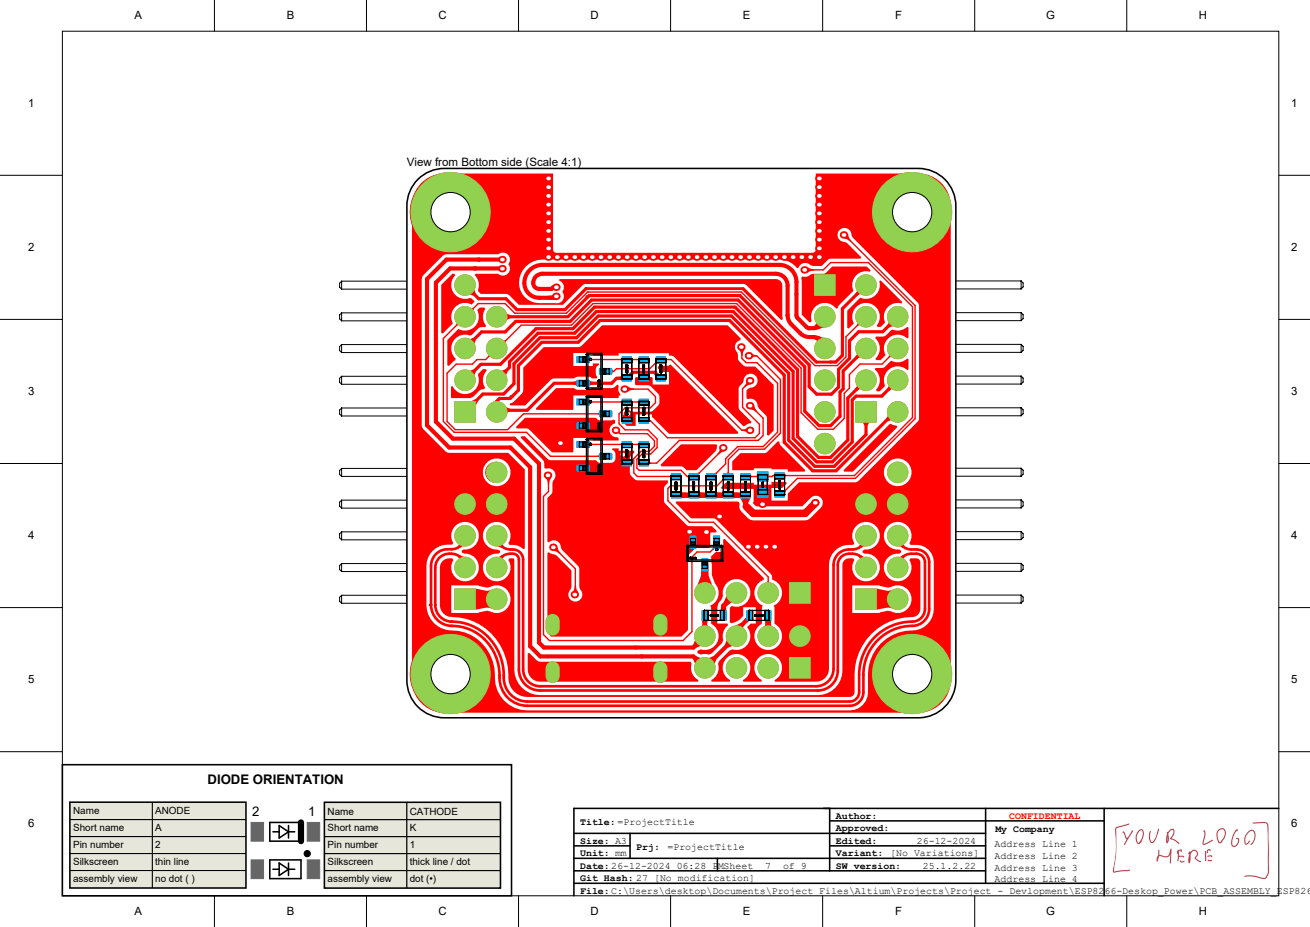
[picture p13: page 11]

View from Bottom side (Scale 4:1)

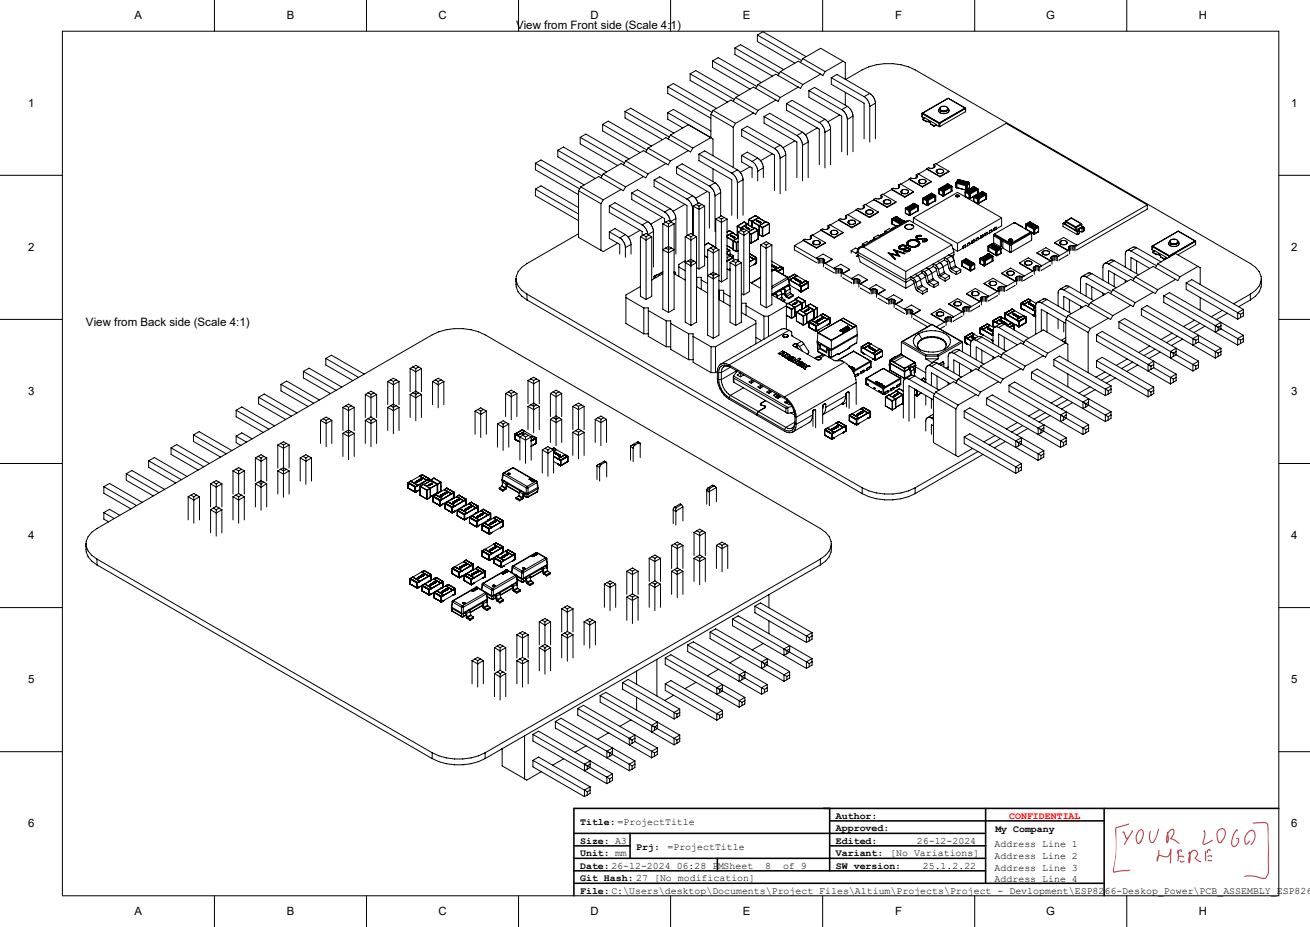
[picture p14: page 12]

View from Front side (Scale 4:1)

View from Back side (Scale 4:1)

Approved: | My Company Address Line 1

Size: A3 | Prj: =ProjectTitle | Edited: 26-12-2024

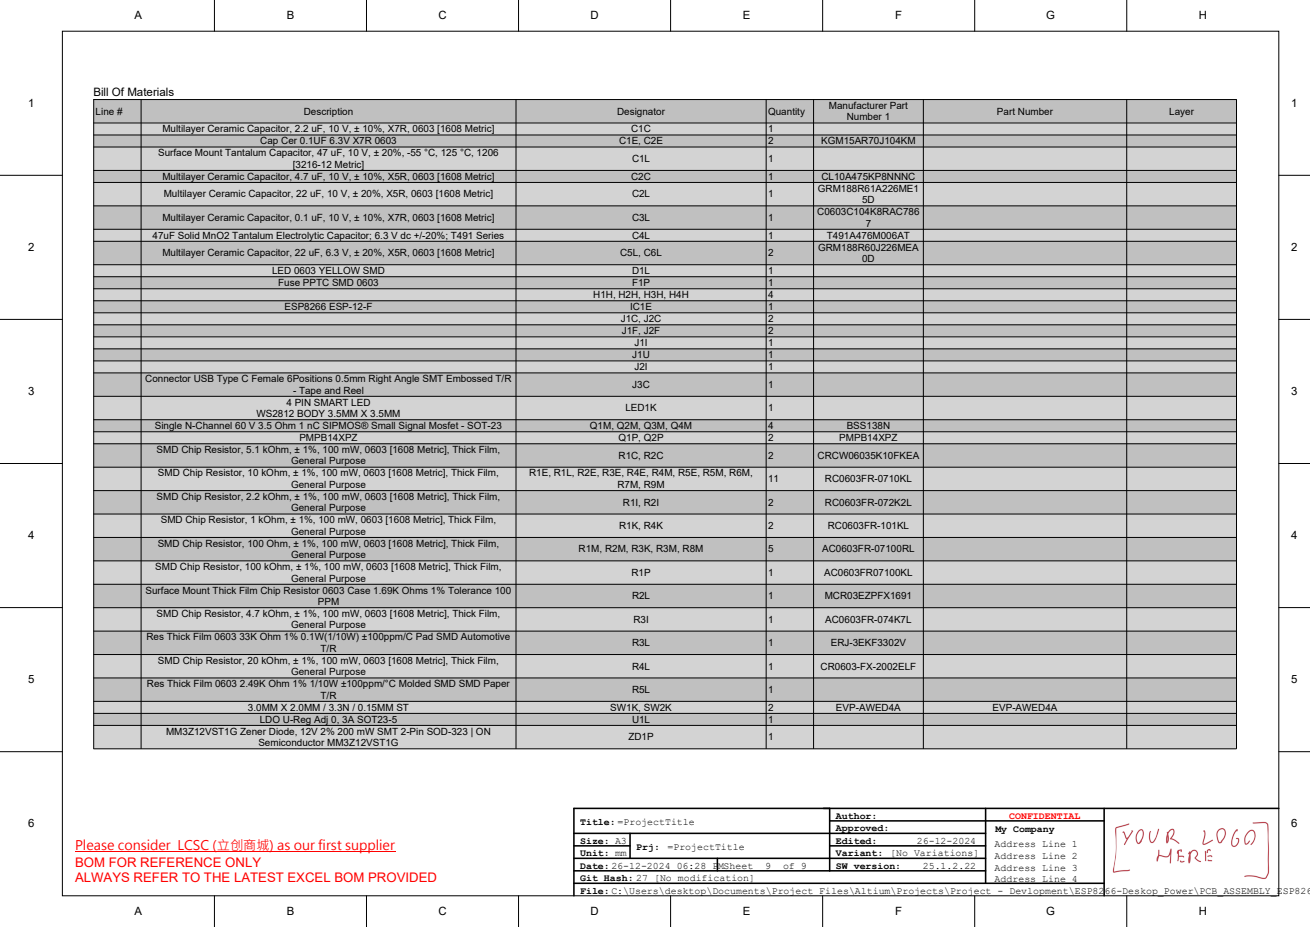
[picture p15: page 13]

Line # | Description | Designator | Quantity | Manufacturer Part Number 1 | Part Number | Layer

Multilayer Ceramic Capacitor, 2.2 uF, 10 V, ± 10%, X7R, 0603 [1608 Metric] | C1C | 1

Cap Cer 0.1UF 6.3V X7R 0603 | C1E, C2E | 2 | KGM15AR70J104KM

Surface Mount Tantalum Capacitor, 47 uF, 10 V, ± 20%, -55 °C, 125 °C, 1206 [3216-12 Metric] | C1L | 1

Multilayer Ceramic Capacitor, 4.7 uF, 10 V, ± 10%, X5R, 0603 [1608 Metric] | C2C | 1 | CL10A475KP8NNNC
Multilayer Ceramic Capacitor, 22 uF, 10 V, ± 20%, X5R, 0603 [1608 Metric] | C2L | 1 | GRM188R61A226ME1 5D

Multilayer Ceramic Capacitor, 0.1 uF, 10 V, ± 10%, X7R, 0603 [1608 Metric] | C3L | 1 | C0603C104K8RAC786 7

47uF Solid MnO2 Tantalum Electrolytic Capacitor; 6.3 V dc +/-20%; T491 Series | C4L | 1 | T491A476M006AT
Multilayer Ceramic Capacitor, 22 uF, 6.3 V, ± 20%, X5R, 0603 [1608 Metric] | C5L, C6L | 2 | GRM188R60J226MEA 0D

LED 0603 YELLOW SMD | D1L | 1
Fuse PPTC SMD 0603 | F1P | 1

ESP8266 ESP-12-F | IC1E | 1

J1C, J2C | 2
J1F, J2F | 2
J1I | 1
J1U | 1
J2I | 1

Connector USB Type C Female 6Positions 0.5mm Right Angle SMT Embossed T/R - Tape and Reel | J3C | 1

4 PIN SMART LED WS2812 BODY 3.5MM X 3.5MM | LED1K | 1

Single N-Channel 60 V 3.5 Ohm 1 nC SIPMOS® Small Signal Mosfet - SOT-23 | Q1M, Q2M, Q3M, Q4M | 4 | BSS138N

PMPB14XPZ | Q1P, Q2P | 2 | PMPB14XPZ

SMD Chip Resistor, 5.1 kOhm, ± 1%, 100 mW, 0603 [1608 Metric], Thick Film, General Purpose | R1C, R2C | 2 | CRCW06035K10FKEA

SMD Chip Resistor, 10 kOhm, ± 1%, 100 mW, 0603 [1608 Metric], Thick Film, General Purpose | R1E, R1L, R2E, R3E, R4E, R4M, R5E, R5M, R6M, R7M, R9M | 11 | RC0603FR-0710KL

SMD Chip Resistor, 2.2 kOhm, ± 1%, 100 mW, 0603 [1608 Metric], Thick Film, General Purpose | R1I, R2I | 2 | RC0603FR-072K2L

SMD Chip Resistor, 1 kOhm, ± 1%, 100 mW, 0603 [1608 Metric], Thick Film, General Purpose | R1K, R4K | 2 | RC0603FR-101KL

SMD Chip Resistor, 100 Ohm, ± 1%, 100 mW, 0603 [1608 Metric], Thick Film, General Purpose | R1M, R2M, R3K, R3M, R8M | 5 | AC0603FR-07100RL

SMD Chip Resistor, 100 kOhm, ± 1%, 100 mW, 0603 [1608 Metric], Thick Film, General Purpose | R1P | 1 | AC0603FR07100KL

Surface Mount Thick Film Chip Resistor 0603 Case 1.69K Ohms 1% Tolerance 100 PPM | R2L | 1 | MCR03EZPFX1691

SMD Chip Resistor, 4.7 kOhm, ± 1%, 100 mW, 0603 [1608 Metric], Thick Film, General Purpose | R3I | 1 | AC0603FR-074K7L

Res Thick Film 0603 33K Ohm 1% 0.1W(1/10W) ±100ppm/C Pad SMD Automotive T/R | R3L | 1 | ERJ-3EKF3302V

SMD Chip Resistor, 20 kOhm, ± 1%, 100 mW, 0603 [1608 Metric], Thick Film, General Purpose | R4L | 1 | CR0603-FX-2002ELF

Res Thick Film 0603 2.49K Ohm 1% 1/10W ±100ppm/°C Molded SMD SMD Paper T/R | R5L | 1

3.0MM X 2.0MM / 3.3N / 0.15MM ST | SW1K, SW2K | 2 | EVP-AWED4A | EVP-AWED4A
LDO U-Reg Adj 0, 3A SOT23-5 | U1L | 1

MM3Z12VST1G Zener Diode, 12V 2% 200 mW SMT 2-Pin SOD-323 | ON Semiconductor MM3Z12VST1G | ZD1P | 1

Please consider LCSC (立创商城) as our first supplier
BOM FOR REFERENCE ONLY
ALWAYS REFER TO THE LATEST EXCEL BOM PROVIDED

Approved: | My Company Address Line 1

Size: A3 | Prj: =ProjectTitle | Edited: 26-12-2024
