bantybanty/ESP8266-Deskop_Power/Project Outputs for ESP8266-Deskop_Power/Verification Report/DRC/ESP8266-Deskop_Power.html

Altium

# Design Rule Verification Report

Date: | | 26-12-2024
Time: | | 17:57:12
Elapsed Time: | | 00:00:00
Filename: | | C:\Users\desktop\Documents\Project Files\Altium\Projects\Project - Devlopment\ESP8266-Deskop_Power\ESP8266-Deskop_Power.PcbDoc

Warnings: | | 0
Rule Violations: | | 0

## Summary

Warnings | Count
Total | 0

Rule Violations | Count
Clearance Constraint (Gap=4mm) (InNetClass('PowerRails_HighVoltage_AC') Or InNetClass('PowerRails_HighVoltage_DC')),(Not InNetClass('PowerRails_HighVoltage_AC') And Not InNetClass('PowerRails_HighVoltage_DC')) | 0
Clearance Constraint (Gap=0.254mm) (InComponentClass('Via_Plugged')),(IsPad) | 0
Clearance Constraint (Gap=0.254mm) (All),(All) | 0
Short-Circuit Constraint (Allowed=No) (All),(not IsBoardCutoutRegion) | 0
Un-Routed Net Constraint ( (All) ) | 0
Modified Polygon (Allow modified: No), (Allow shelved: No) | 0
Width Constraint (Min=0.2mm) (Max=25.4mm) (Preferred=0.3mm) (InNetClass('PowerRails_LowVoltage_DC')) | 0
Width Constraint (Min=0.11mm) (Max=0.11mm) (Preferred=0.11mm) (InNetClass('Signal_75_ohm')) | 0
Width Constraint (Min=0.2mm) (Max=25.4mm) (Preferred=0.3mm) (InNetClass('GND')) | 0
Width Constraint (Min=0.11mm) (Max=0.11mm) (Preferred=0.11mm) (InNetClass('Signal')) | 0
Width Constraint (Min=0.303mm) (Max=0.303mm) (Preferred=0.303mm) (InNetClass('Signal_50_ohm')) | 0
Width Constraint (Min=0.18mm) (Max=0.4mm) (Preferred=0.254mm) (InNetClass('Power_Signal')) | 0
Routing Layers(All) | 0
Routing Via (MinHoleWidth=0.3mm) (MaxHoleWidth=0.5mm) (PreferredHoleWidth=0.3mm) (MinWidth=0.45mm) (MaxWidth=1mm) (PreferedWidth=0.6mm) (All) | 0
Differential Pairs Uncoupled Length using the Gap Constraints (Min=0.127mm) (Max=0.127mm) (Prefered=0.127mm) and Width Constraints (Min=0.213mm) (Max=0.213mm) (Prefered=0.213mm) (InDifferentialPairClass('USB_DATA')) | 0
Differential Pairs Uncoupled Length using the Gap Constraints (Min=0.381mm) (Max=0.381mm) (Prefered=0.381mm) and Width Constraints (Min=0.329mm) (Max=0.329mm) (Prefered=0.329mm) (InDifferentialPairClass('UART')) | 0
Differential Pairs Uncoupled Length using the Gap Constraints (Min=0.381mm) (Max=0.381mm) (Prefered=0.381mm) and Width Constraints (Min=0.329mm) (Max=0.329mm) (Prefered=0.329mm) (InDifferentialPairClass('I2C')) | 0
SMD To Corner (Distance=0.127mm) (All) | 0
SMD Neck-Down Constraint (Percent=90%) (not IsTestpoint and not InNetClass('PowerRails_LowVoltage_DC') and not InNetClass('PowerRails_GND')) | 0
SMD Entry (Side = Allowed) (Corner = Allowed) (Any Angle = Not Allowed) (Ignore First Corner = Allowed) | 0
Power Plane Connect Rule(Relief Connect )(Expansion=0.508mm) (Conductor Width=0.254mm) (Air Gap=0.254mm) (Entries=4) (All) | 0
Minimum Annular Ring (Minimum=0.2mm) (IsThruPin) | 0
Minimum Annular Ring (Minimum=0.075mm) (IsVia) | 0
Acute Angle Constraint [Tracks Only] (Minimum=60.000) (All) | 0
Hole Size Constraint (Min=0.3mm) (Max=6.3mm) (All) | 0
Pads and Vias to follow the Drill pairs settings | 0
Hole To Hole Clearance (Gap=0.45mm) (ispad),(IsPad) | 0
Minimum Solder Mask Sliver (Gap=0.13mm) (All),(All) | 0
Silk To Solder Mask (Clearance=0.15mm) (All),(All) | 0
Silk to Silk (Clearance=0.102mm) (All),(All) | 0
Net Antennae (Tolerance=0mm) (All) | 0
Board Clearance Constraint (Gap=0mm) ((OnLayer('Top Layer') OR OnLayer('Bottom Layer') )) | 0
Height Constraint (Min=0mm) (Max=1816.048mm) (Prefered=12.7mm) (All) | 0
Total | 0
