bantybanty/ESP8266-Deskop_Power/Project Outputs for ESP8266-Deskop_Power/Verification Report/ERC/ESP8266-Deskop_Power.html

Altium

# Electrical Rule Check Report

Date: | | 26-12-2024
Time: | | 17:57:13
Filename: | | C:\Users\desktop\Documents\Project Files\Altium\Projects\Project - Devlopment\ESP8266-Deskop_Power\Project Outputs for ESP8266-Deskop_Power\Verification Report\ERC\ESP8266-Deskop_Power.html

Class | Document | Message
Warning | 5_Keys_And_Status.SchDoc | Net WS2812B_DATA has no driving source (Pin LED1K-4, Pin R3K-1)

Back to top
