bantybanty/ESP8266-Deskop_Power/Project Outputs for ESP8266-Deskop_Power/Verification Report/FootprintComparison/ESP8266-Deskop_Power.html

Altium customize

# Footprint Comparison Report

Date: | | 26-12-2024
Time: | | 17:57:16
Elapsed Time: | | 00:00:01
Filename: | | C:\Users\desktop\Documents\Project Files\Altium\Projects\Project - Devlopment\ESP8266-Deskop_Power\ESP8266-Deskop_Power.PcbDoc

## Contents

Contents

Components Status Summary

Matched Components List

Footprints Not Found

## Components Status Summary

## Matched Components List

Designator | Footprint | Footprint reference | Footprint to reference Library
C1C | C0603-IPC_C_No_Silk | C0603-IPC_C_No_Silk | C:\Users\desktop\Documents\Project Files\Altium\Projects_Libraries\Lib_Capacitor\Lib_Capacitor_0603\Project Outputs for Lib_Capacitor_0603\Lib_Capacitor_0603.IntLib
C1E | C0603-IPC_C_No_Silk | C0603-IPC_C_No_Silk | C:\Users\desktop\Documents\Project Files\Altium\Projects_Libraries\Lib_Capacitor\Lib_Capacitor_0603\Project Outputs for Lib_Capacitor_0603\Lib_Capacitor_0603.IntLib
C1L | CAP POL 1206_3216-MFG | CAP POL 1206_3216-MFG | C:\Users\desktop\Documents\Project Files\Altium\Projects_Libraries\Lib_Capacitor\Lib_Capacitor_1206_Polarised\Project Outputs for Lib_Capacitor_1206_Polarised\Lib_Capacitor_1206_Polarised.IntLib
C2C | C0603-IPC_C_No_Silk | C0603-IPC_C_No_Silk | C:\Users\desktop\Documents\Project Files\Altium\Projects_Libraries\Lib_Capacitor\Lib_Capacitor_0603\Project Outputs for Lib_Capacitor_0603\Lib_Capacitor_0603.IntLib
C2E | C0603-IPC_C_No_Silk | C0603-IPC_C_No_Silk | C:\Users\desktop\Documents\Project Files\Altium\Projects_Libraries\Lib_Capacitor\Lib_Capacitor_0603\Project Outputs for Lib_Capacitor_0603\Lib_Capacitor_0603.IntLib
C2L | C0603-IPC_C_No_Silk | C0603-IPC_C_No_Silk | C:\Users\desktop\Documents\Project Files\Altium\Projects_Libraries\Lib_Capacitor\Lib_Capacitor_0603\Project Outputs for Lib_Capacitor_0603\Lib_Capacitor_0603.IntLib
C3L | C0603-IPC_C_No_Silk | C0603-IPC_C_No_Silk | C:\Users\desktop\Documents\Project Files\Altium\Projects_Libraries\Lib_Capacitor\Lib_Capacitor_0603\Project Outputs for Lib_Capacitor_0603\Lib_Capacitor_0603.IntLib
C4L | CAP POL 1206_3216-MFG | CAP POL 1206_3216-MFG | C:\Users\desktop\Documents\Project Files\Altium\Projects_Libraries\Lib_Capacitor\Lib_Capacitor_1206_Polarised\Project Outputs for Lib_Capacitor_1206_Polarised\Lib_Capacitor_1206_Polarised.IntLib
C5L | C0603-IPC_C_No_Silk | C0603-IPC_C_No_Silk | C:\Users\desktop\Documents\Project Files\Altium\Projects_Libraries\Lib_Capacitor\Lib_Capacitor_0603\Project Outputs for Lib_Capacitor_0603\Lib_Capacitor_0603.IntLib
C6L | C0603-IPC_C_No_Silk | C0603-IPC_C_No_Silk | C:\Users\desktop\Documents\Project Files\Altium\Projects_Libraries\Lib_Capacitor\Lib_Capacitor_0603\Project Outputs for Lib_Capacitor_0603\Lib_Capacitor_0603.IntLib
D1L | LED_0603_YELLOW | LED_0603_YELLOW | C:\Users\desktop\Documents\Project Files\Altium\Projects_Libraries\Lib_LED\Project Outputs for Lib_LED\Lib_LED.IntLib
F1P | R0603-IPC_C | R0603-IPC_C | C:\Users\desktop\Documents\Project Files\Altium\Projects_Libraries\Lib_Fuse\Project Outputs for Lib_Fuse\Lib_Fuse.IntLib
H1H | MountingHole_3.2mm_M3_Pad_Via_Mask | MountingHole_3.2mm_M3_Pad_Via_Mask | C:\Users\desktop\Documents\Project Files\Altium\Projects_Libraries\Lib_MountingHole\Project Outputs for Lib_MountingHole\Lib_MountingHole.IntLib
H2H | MountingHole_3.2mm_M3_Pad_Via_Mask | MountingHole_3.2mm_M3_Pad_Via_Mask | C:\Users\desktop\Documents\Project Files\Altium\Projects_Libraries\Lib_MountingHole\Project Outputs for Lib_MountingHole\Lib_MountingHole.IntLib
H3H | MountingHole_3.2mm_M3_Pad_Via_Mask | MountingHole_3.2mm_M3_Pad_Via_Mask | C:\Users\desktop\Documents\Project Files\Altium\Projects_Libraries\Lib_MountingHole\Project Outputs for Lib_MountingHole\Lib_MountingHole.IntLib
H4H | MountingHole_3.2mm_M3_Pad_Via_Mask | MountingHole_3.2mm_M3_Pad_Via_Mask | C:\Users\desktop\Documents\Project Files\Altium\Projects_Libraries\Lib_MountingHole\Project Outputs for Lib_MountingHole\Lib_MountingHole.IntLib
IC1E | ESP8266 ESP-12-Large | ESP8266 ESP-12-Large | C:\Users\desktop\Documents\Project Files\Altium\Projects_Libraries\Lib_Modules\Lib_ESP8266\Project Outputs for Lib_ESP8266\Lib_ESP8266.IntLib
J1C | USB_Front_Pannel_2x05_P2.54mm_Horizontal_Right | USB_Front_Pannel_2x05_P2.54mm_Horizontal_Right | C:\Users\desktop\Documents\Project Files\Altium\Projects_Libraries\Lib_Connector\Lib_Connector_PinHeader_2.54mm\Project Outputs for Lib_Connector_PinHeader_2.54mm\Lib_Connector_PinHeader_2.54mm.IntLib
J1F | Front_Pannel_2x05_P2.54mm_Horizontal_Right | Front_Pannel_2x05_P2.54mm_Horizontal_Right | C:\Users\desktop\Documents\Project Files\Altium\Projects_Libraries\Lib_Connector\Lib_Connector_PinHeader_2.54mm\Project Outputs for Lib_Connector_PinHeader_2.54mm\Lib_Connector_PinHeader_2.54mm.IntLib
J1I | PinHeader_2x04_P2.54mm_Vertical | PinHeader_2x04_P2.54mm_Vertical | C:\Users\desktop\Documents\Project Files\Altium\Projects_Libraries\Lib_Connector\Lib_Connector_PinHeader_2.54mm\Project Outputs for Lib_Connector_PinHeader_2.54mm\Lib_Connector_PinHeader_2.54mm.IntLib
J2C | USB_Front_Pannel_2x05_P2.54mm_Horizontal_Left | USB_Front_Pannel_2x05_P2.54mm_Horizontal_Left | C:\Users\desktop\Documents\Project Files\Altium\Projects_Libraries\Lib_Connector\Lib_Connector_PinHeader_2.54mm\Project Outputs for Lib_Connector_PinHeader_2.54mm\Lib_Connector_PinHeader_2.54mm.IntLib
J2F | Front_Pannel_2x05_P2.54mm_Horizontal_Left | Front_Pannel_2x05_P2.54mm_Horizontal_Left | C:\Users\desktop\Documents\Project Files\Altium\Projects_Libraries\Lib_Connector\Lib_Connector_PinHeader_2.54mm\Project Outputs for Lib_Connector_PinHeader_2.54mm\Lib_Connector_PinHeader_2.54mm.IntLib
J2I | PinHeader_1x04_P2.54mm_Vertical | PinHeader_1x04_P2.54mm_Vertical | C:\Users\desktop\Documents\Project Files\Altium\Projects_Libraries\Lib_Connector\Lib_Connector_PinHeader_2.54mm\Project Outputs for Lib_Connector_PinHeader_2.54mm\Lib_Connector_PinHeader_2.54mm.IntLib
J3C | USB-Type-C-6-Pin-SMT | USB-Type-C-6-Pin-SMT | C:\Users\desktop\Documents\Project Files\Altium\Projects_Libraries\Lib_Connector\Project Outputs for Lib_Connector\Lib_Connector.IntLib
LED1K | WS2812B-Mini_3535 | WS2812B-Mini_3535 | C:\Users\desktop\Documents\Project Files\Altium\Projects_Libraries\Lib_LED\Project Outputs for Lib_LED\Lib_LED.IntLib
Q1M | SOT-23-3-IPC_C | SOT-23-3-IPC_C | C:\Users\desktop\Documents\Project Files\Altium\Projects_Libraries\Lib_FET\Lib_Mosfet_NPN\Project Outputs for Lib_Mosfet_NPN\Lib_Mosfet_NPN.IntLib
Q1P | DFN2020MD-MFG | DFN2020MD-MFG | C:\Users\desktop\Documents\Project Files\Altium\Projects_Libraries\Lib_FET\Lib_Mosfet_PNP\Project Outputs for Lib_Mosfet_PNP\Lib_Mosfet_PNP.IntLib
Q2M | SOT-23-3-IPC_C | SOT-23-3-IPC_C | C:\Users\desktop\Documents\Project Files\Altium\Projects_Libraries\Lib_FET\Lib_Mosfet_NPN\Project Outputs for Lib_Mosfet_NPN\Lib_Mosfet_NPN.IntLib
Q2P | DFN2020MD-MFG | DFN2020MD-MFG | C:\Users\desktop\Documents\Project Files\Altium\Projects_Libraries\Lib_FET\Lib_Mosfet_PNP\Project Outputs for Lib_Mosfet_PNP\Lib_Mosfet_PNP.IntLib
Q3M | SOT-23-3-IPC_C | SOT-23-3-IPC_C | C:\Users\desktop\Documents\Project Files\Altium\Projects_Libraries\Lib_FET\Lib_Mosfet_NPN\Project Outputs for Lib_Mosfet_NPN\Lib_Mosfet_NPN.IntLib
Q4M | SOT-23-3-IPC_C | SOT-23-3-IPC_C | C:\Users\desktop\Documents\Project Files\Altium\Projects_Libraries\Lib_FET\Lib_Mosfet_NPN\Project Outputs for Lib_Mosfet_NPN\Lib_Mosfet_NPN.IntLib
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
R5L | R0603-MFG | R0603-MFG | C:\Users\desktop\Documents\Project Files\Altium\Projects_Libraries\Lib_Register\Lib_Register_0603\Project Outputs for Lib_Register_0603\Lib_Register_0603.IntLib
R5M | R0603-MFG | R0603-MFG | C:\Users\desktop\Documents\Project Files\Altium\Projects_Libraries\Lib_Register\Lib_Register_0603\Project Outputs for Lib_Register_0603\Lib_Register_0603.IntLib
R6M | R0603-MFG | R0603-MFG | C:\Users\desktop\Documents\Project Files\Altium\Projects_Libraries\Lib_Register\Lib_Register_0603\Project Outputs for Lib_Register_0603\Lib_Register_0603.IntLib
R7M | R0603-MFG | R0603-MFG | C:\Users\desktop\Documents\Project Files\Altium\Projects_Libraries\Lib_Register\Lib_Register_0603\Project Outputs for Lib_Register_0603\Lib_Register_0603.IntLib
R8M | R0603-MFG | R0603-MFG | C:\Users\desktop\Documents\Project Files\Altium\Projects_Libraries\Lib_Register\Lib_Register_0603\Project Outputs for Lib_Register_0603\Lib_Register_0603.IntLib
R9M | R0603-MFG | R0603-MFG | C:\Users\desktop\Documents\Project Files\Altium\Projects_Libraries\Lib_Register\Lib_Register_0603\Project Outputs for Lib_Register_0603\Lib_Register_0603.IntLib
SW1K | PANASONIC EVPAW | PANASONIC EVPAW | C:\Users\desktop\Documents\github\altium-library\Celestial Altium Library - altium_library.DbLib/Switches - Tactile
SW2K | PANASONIC EVPAW | PANASONIC EVPAW | C:\Users\desktop\Documents\github\altium-library\Celestial Altium Library - altium_library.DbLib/Switches - Tactile
U1L | TSOT-23-5-IPC-A | TSOT-23-5-IPC-A | C:\Users\desktop\Documents\Project Files\Altium\Projects_Libraries\Lib_LDO\Project Outputs for Lib_LDO\Lib_LDO.IntLib
ZD1P | SOD-323 | SOD-323 | C:\Users\desktop\Documents\Project Files\Altium\Projects_Libraries\Lib_Diodes\Project Outputs for Lib_Diodes\Lib_Diodes.IntLib

Back to top

## Footprints Not Found

Designator | Footprint | Library to install
J1U | PinHeader_1x06_P2.54mm_Vertical_No_3D | Lib_Connector_PinHeader_2.54mm.IntLib

Back to top
