bantybanty/ESP8266-Deskop_Power/Project Outputs for ESP8266-Deskop_Power/Full Documentation/DRC/Design Rules Check.PDF

### Design Rules Verification Report

Filename : C:\Users\desktop\Documents\Project Files\Altium\Projects\Project - Devlopment\ESP8266-Deskop_Power\ESP8266-Deskop_Power.Pc | Warnings 0

### Rule Violations 0

Warnings
Total | 0
Thursday 26 Dec 2024 6:30:08 PM | Page 1 of 2

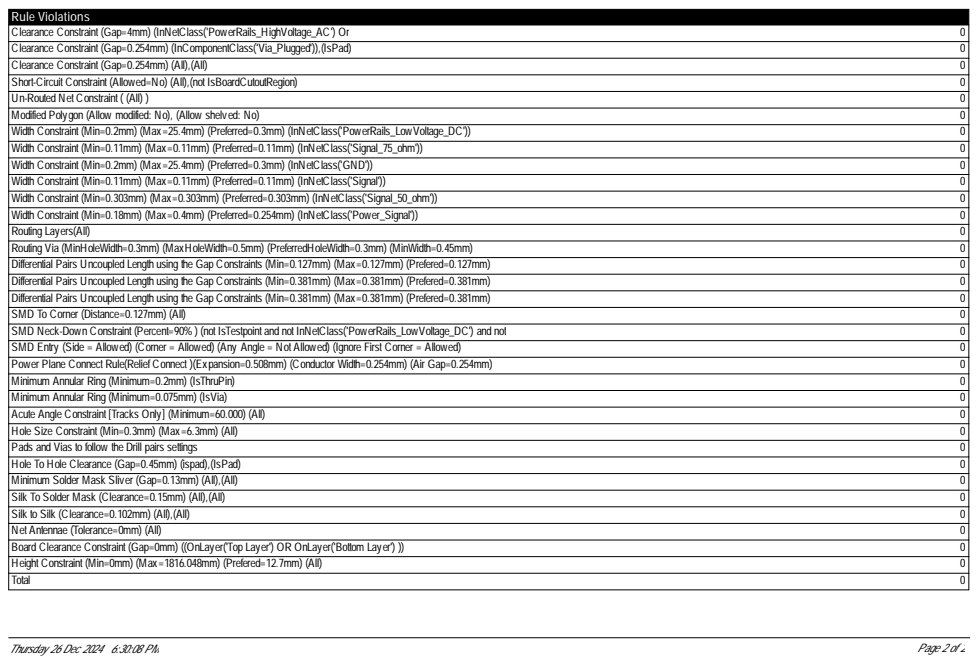
[picture p16: page 2]
