bantybanty/ESP8266-Deskop_Power/Project Outputs for ESP8266-Deskop_Power/Full Documentation/PCB 3D Print/PCB 3D Print Bare Board.PDF

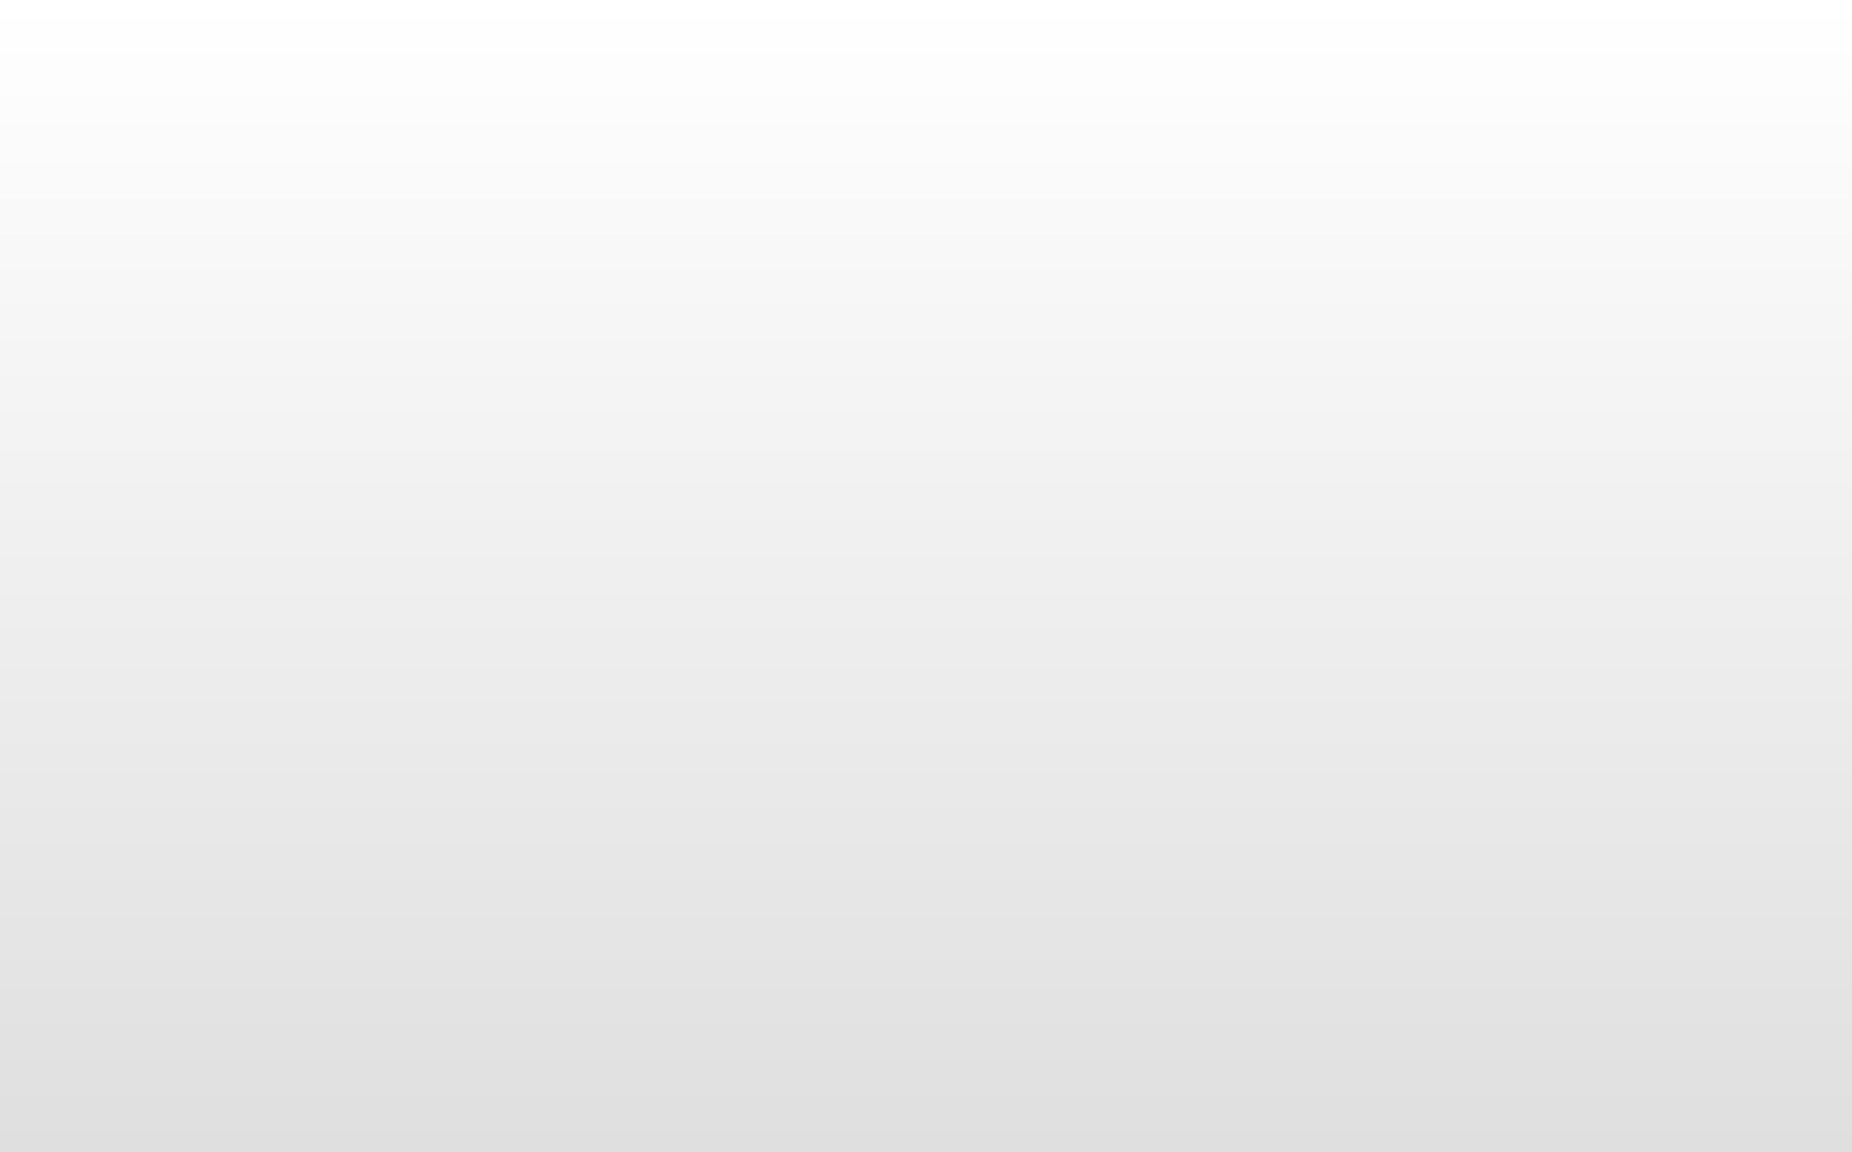
[picture p17: page 1]
