bantybanty/ESP8266-Deskop_Power/Project Outputs for ESP8266-Deskop_Power/Full Documentation/PCB Print/Assembly Drawings.PDF

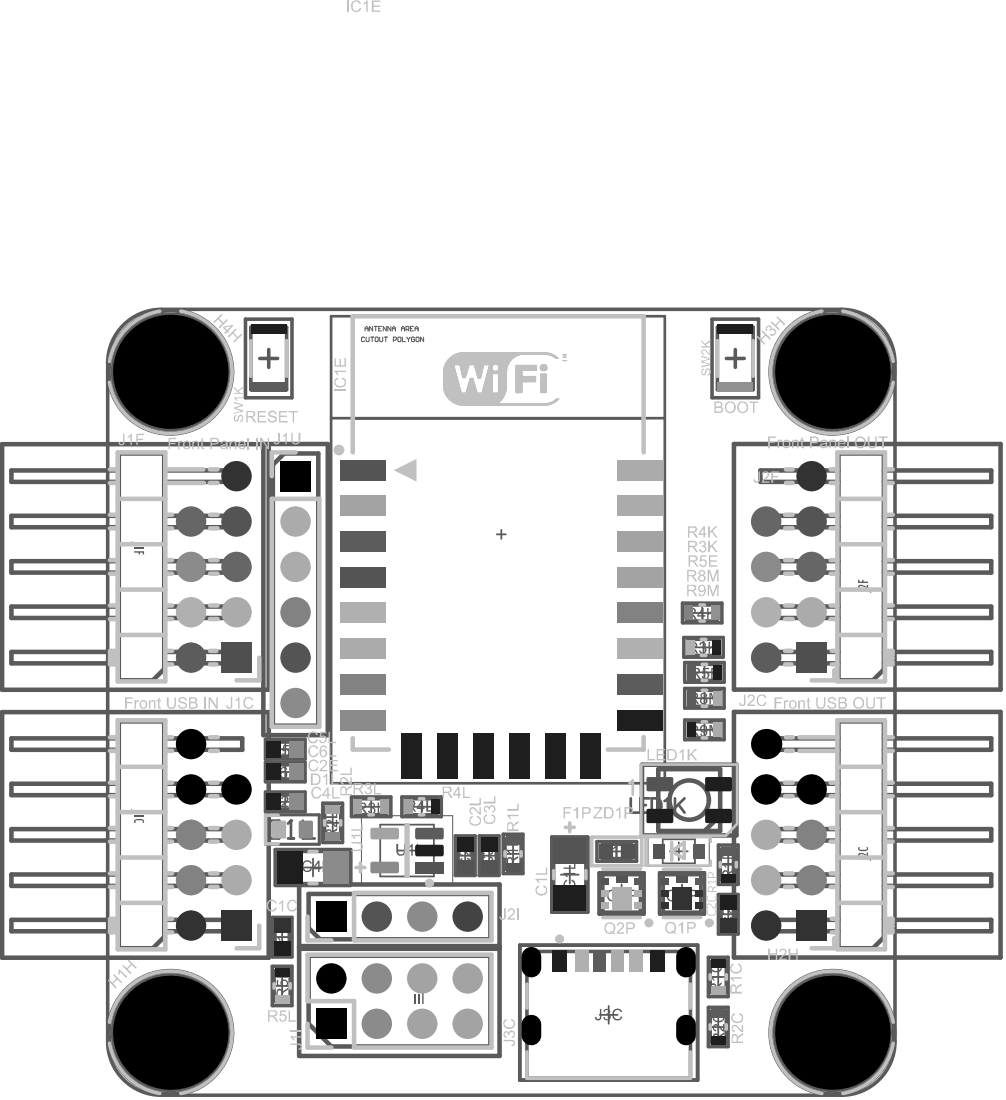
[picture p18: page 1]

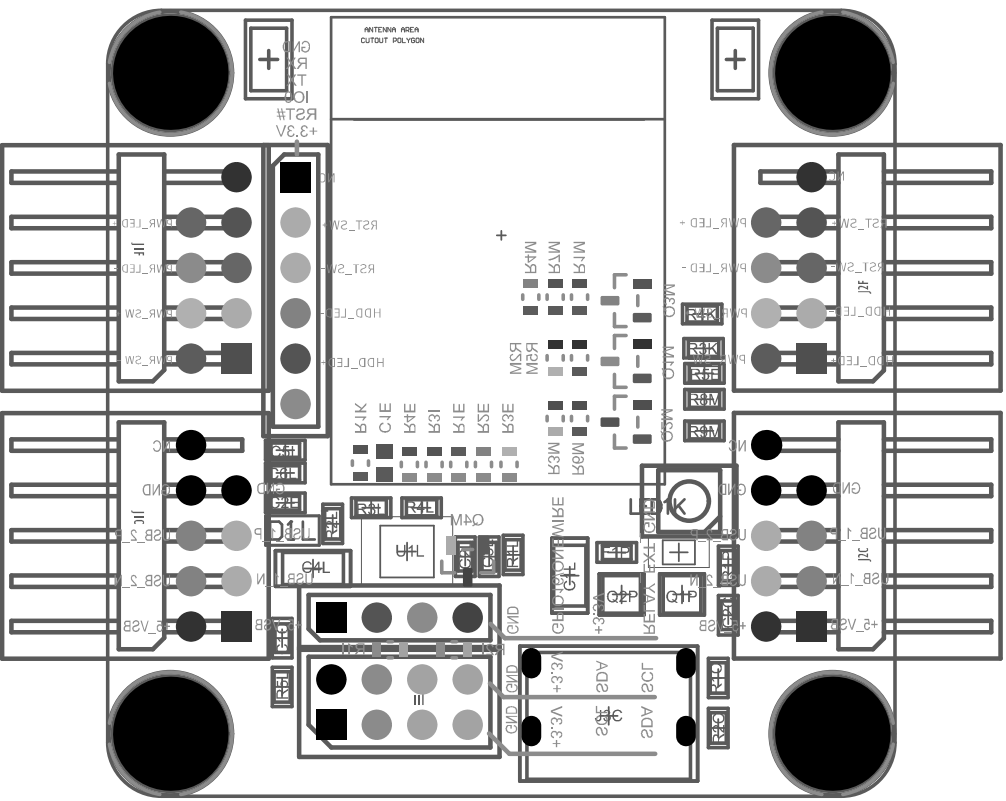
[picture p19: page 2]
