bantybanty/ESP8266-Deskop_Power/Project Outputs for ESP8266-Deskop_Power/Full Documentation/PCB Print/Composite Drawing.PDF

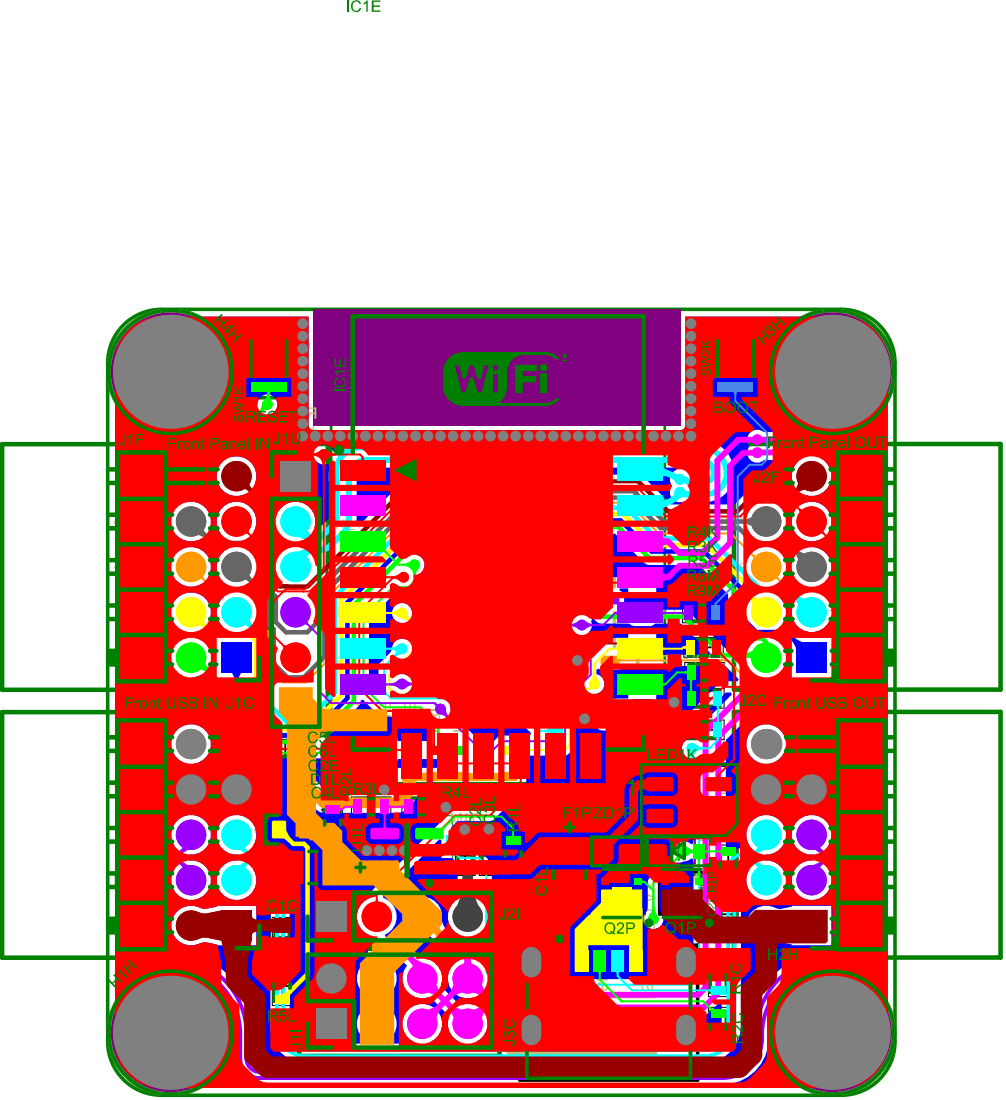
[picture p20: page 1]
