bantybanty/ESP8266-Deskop_Power/Project Outputs for ESP8266-Deskop_Power/Full Documentation/PCB Print/Composite Drill Drawing.PDF

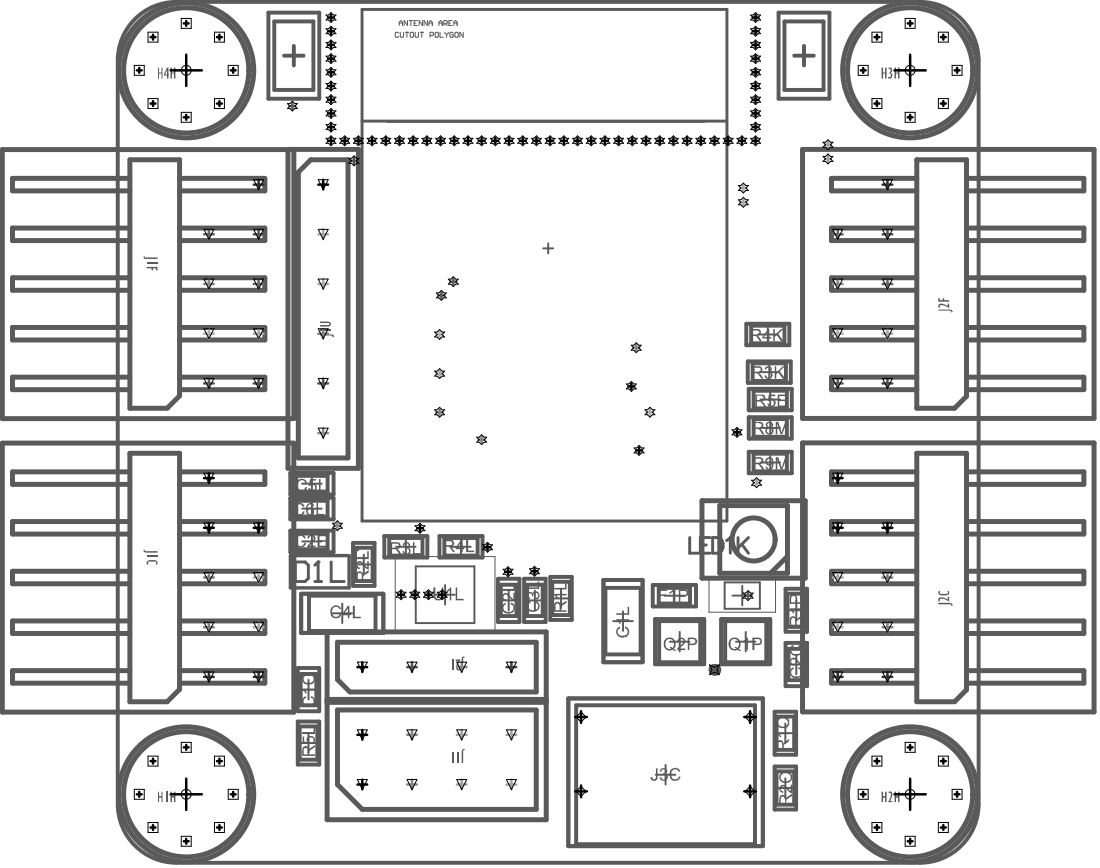
[picture p21: page 1]
