bantybanty/ESP8266-Deskop_Power/Project Outputs for ESP8266-Deskop_Power/Full Documentation/PCB Print/PCB Prints.PDF

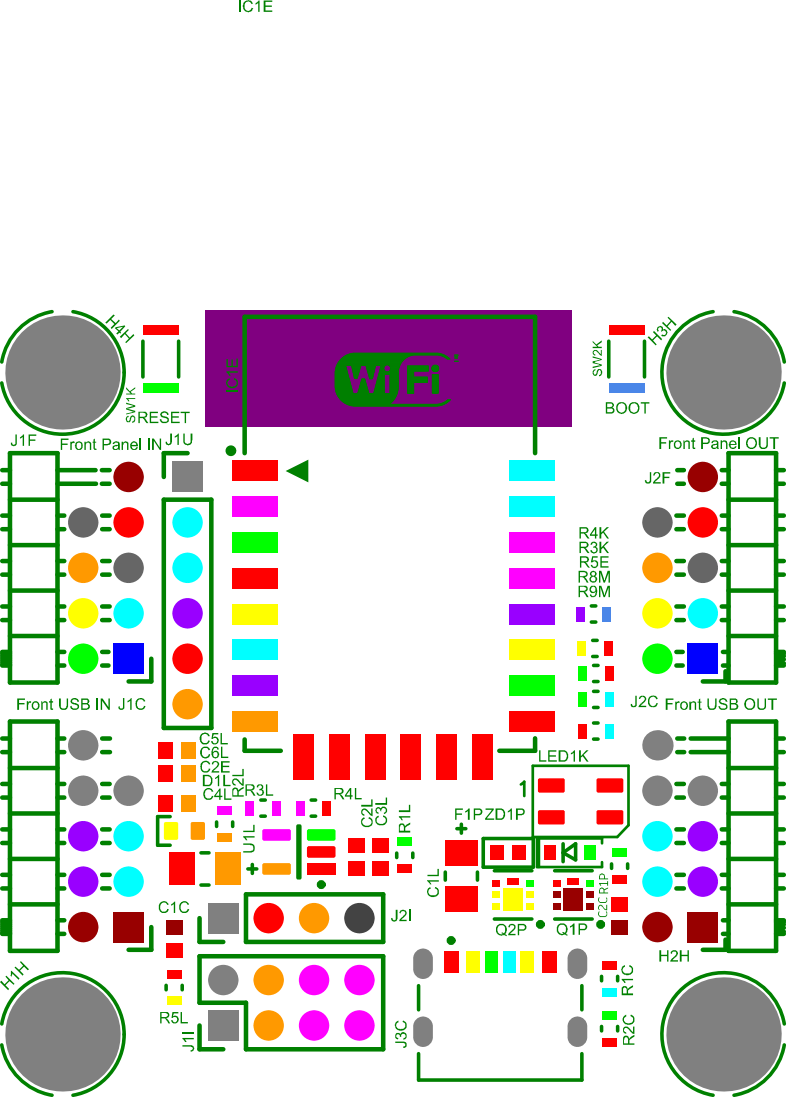
[picture p22: page 1]

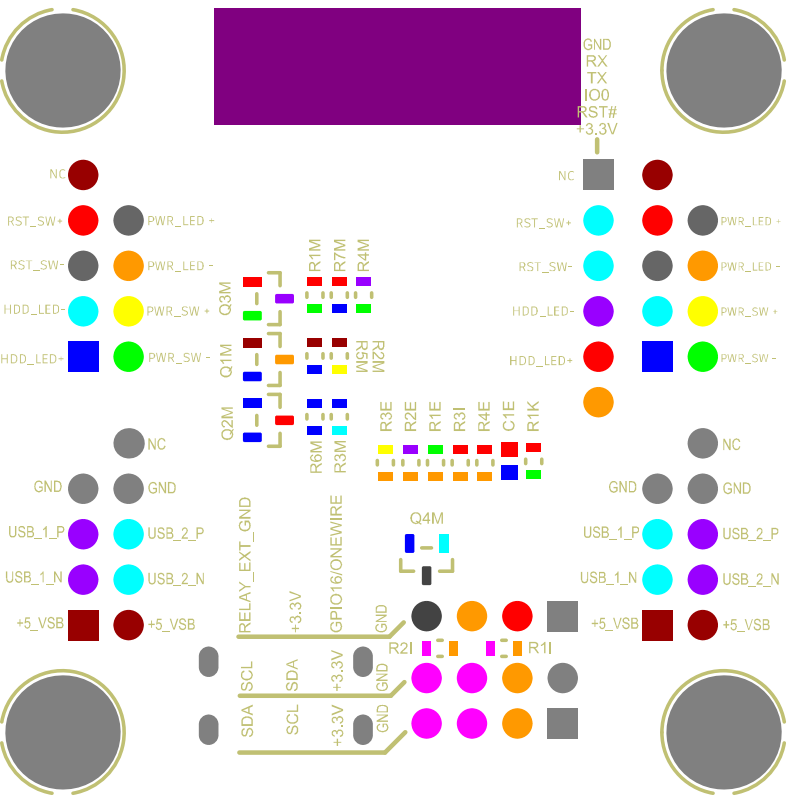
[picture p23: page 2]
