bantybanty/ESP8266-Deskop_Power/Project Outputs for ESP8266-Deskop_Power/Full Documentation/Schematic Print/Schematic Prints.PDF

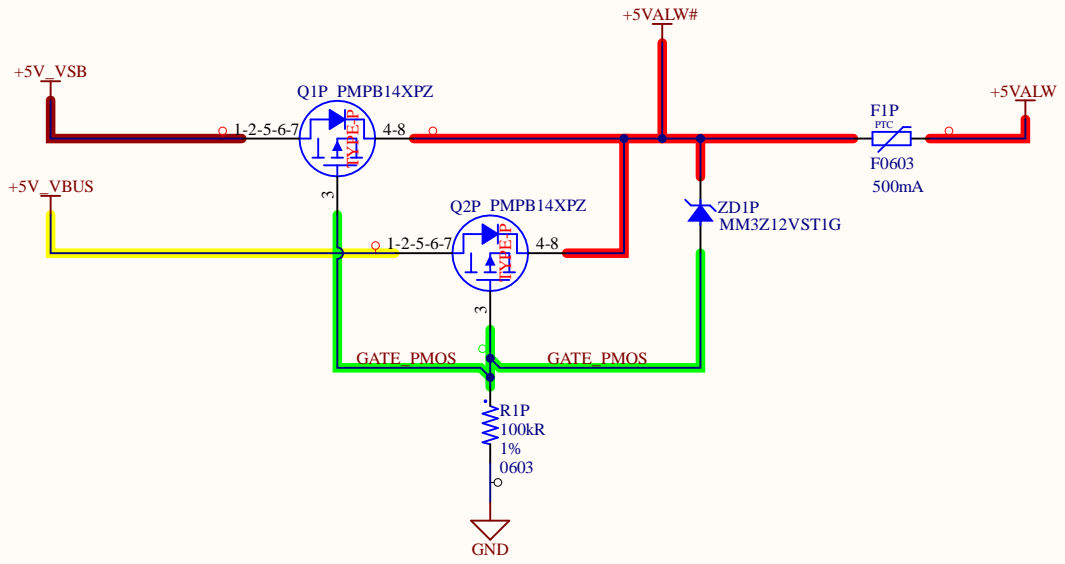
[picture p24: page 1]

18:28:29 Date: | Variant: [No Variations] | INDIA 26-12-2024

Git Hash: 12

File: C:\Users\desktop\Documents\Project Files\Altium\Projects\Project - Devlopment\ESP8266-Deskop_Power\1_Power_Path.SchDoc

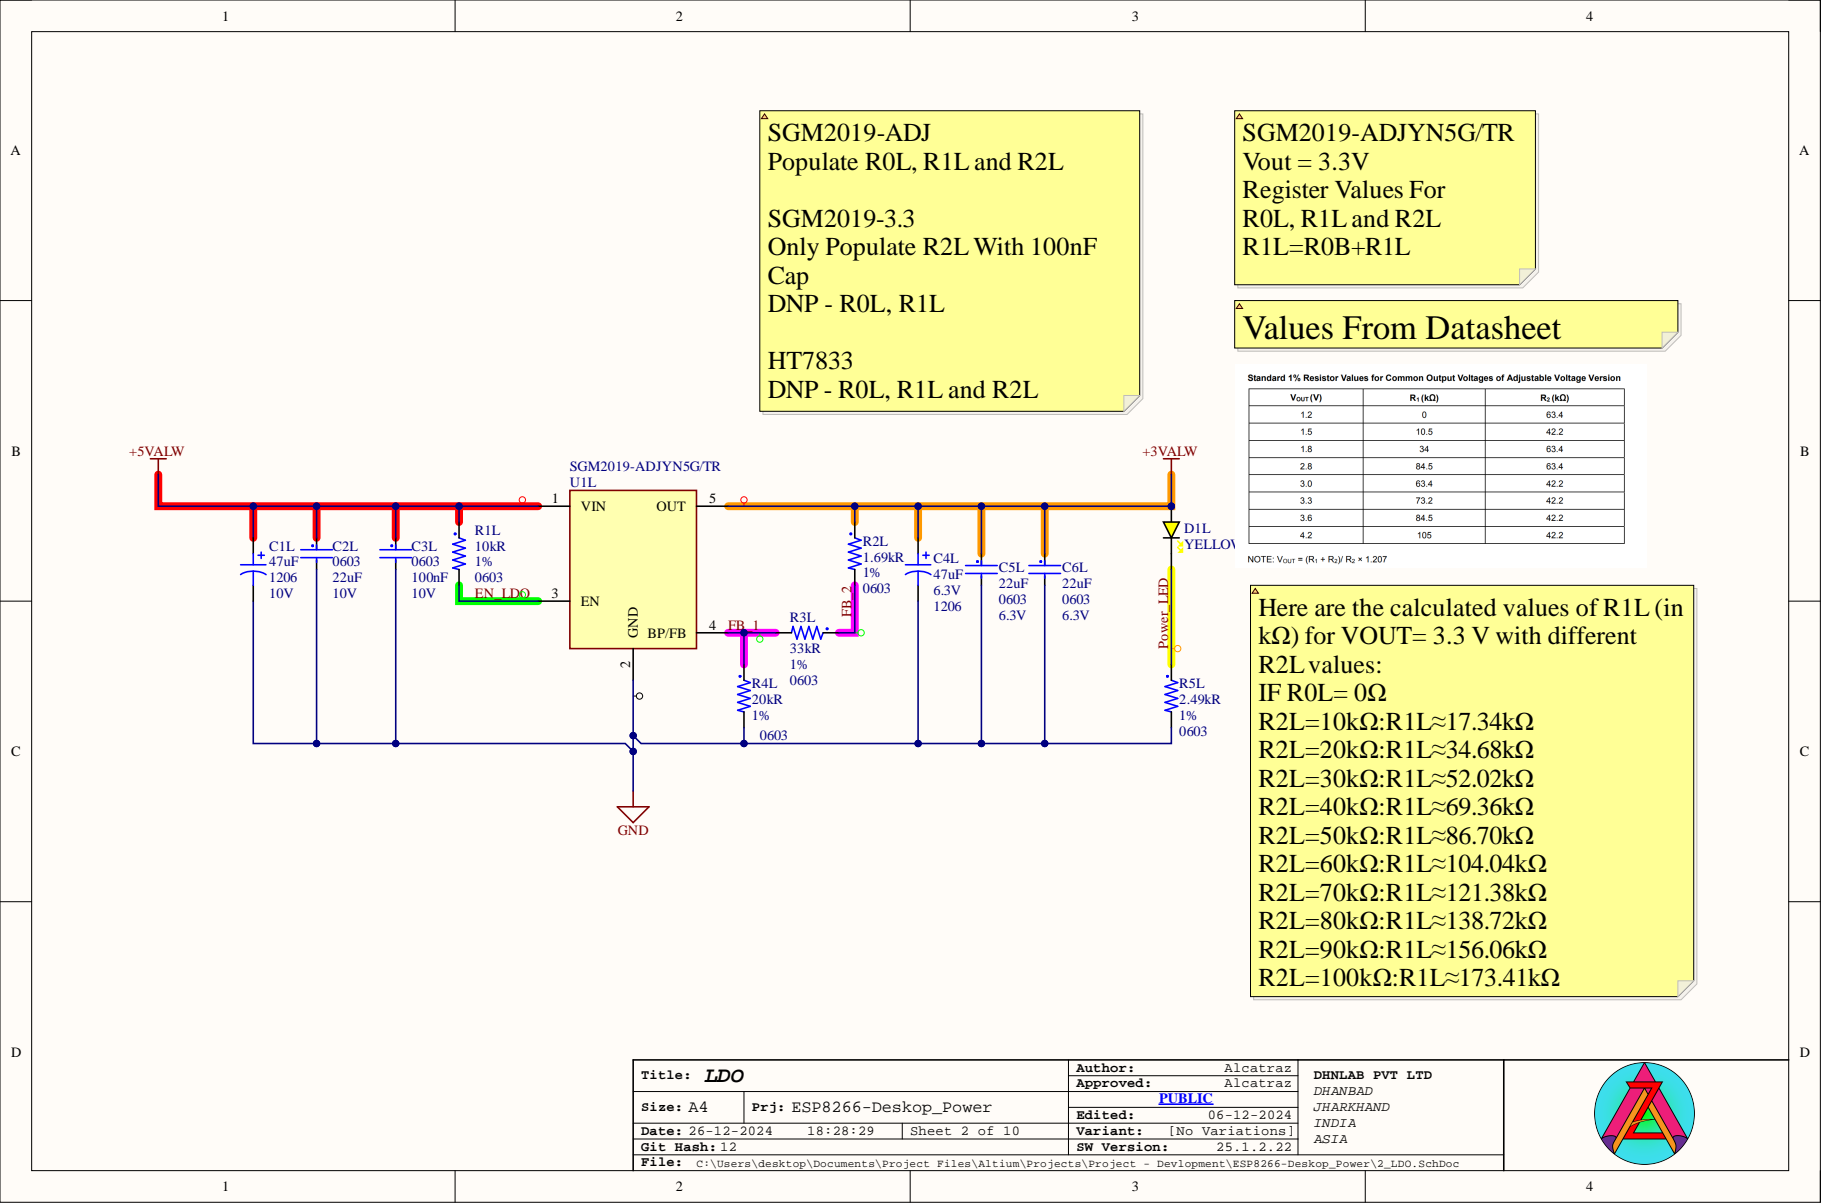
[picture p25: page 2]

D a t -: | [ ] N
G H s h | W V o n .

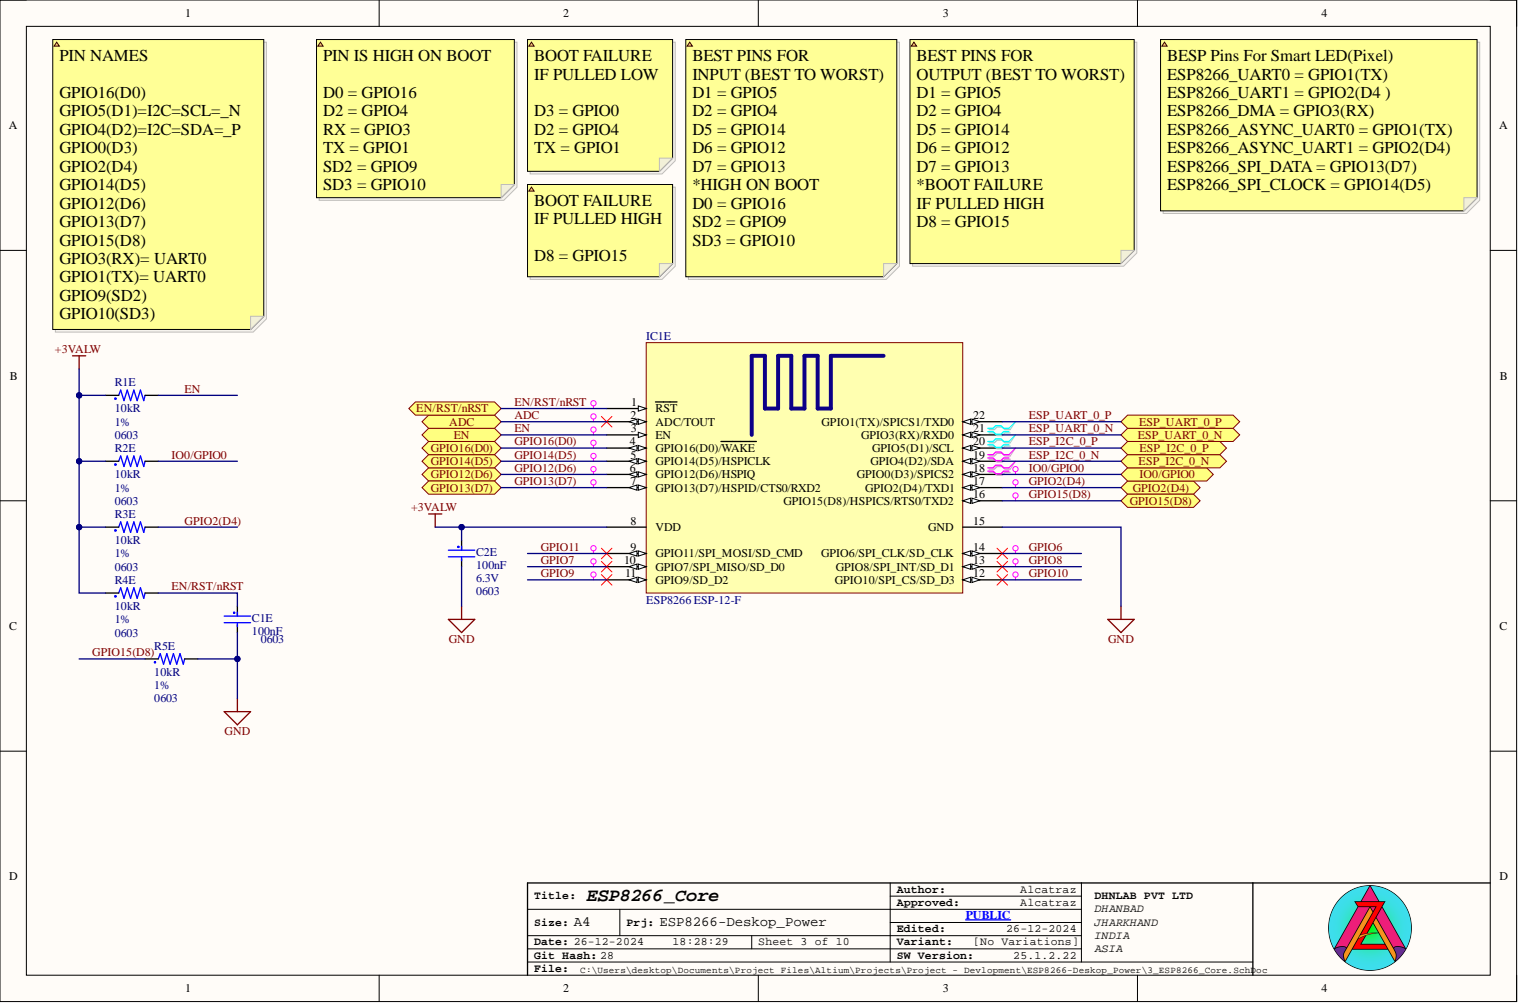
[picture p26: page 3]

BESP Pins For Smart LED(Pixel
ESP8266_U

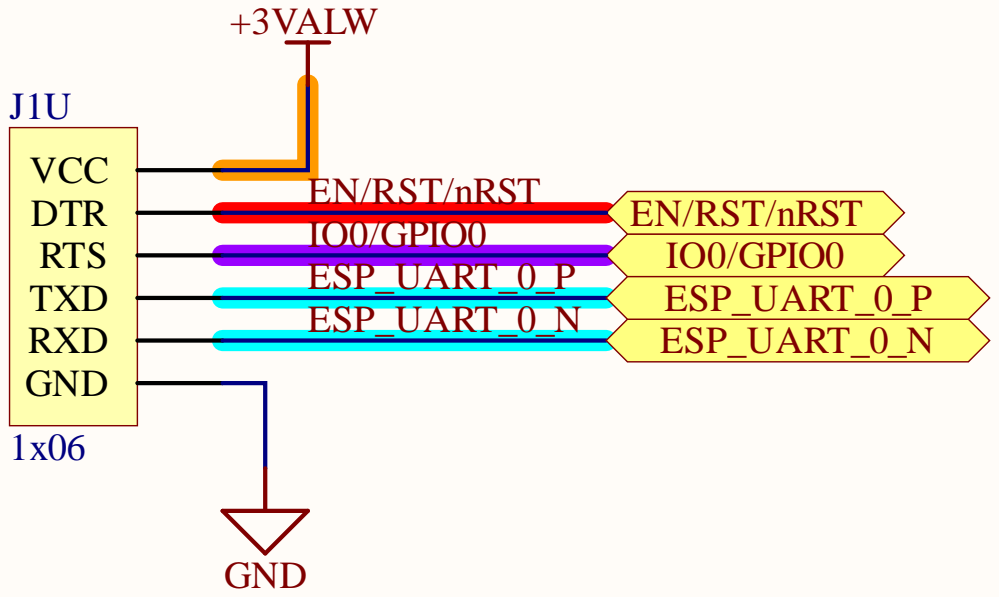
[picture p27: page 4]

File: C:\Users\desktop\Documents\Project Files\Altium\Projects\Project - Devlopment\ESP8266-Deskop_Power\4_UART.SchDoc

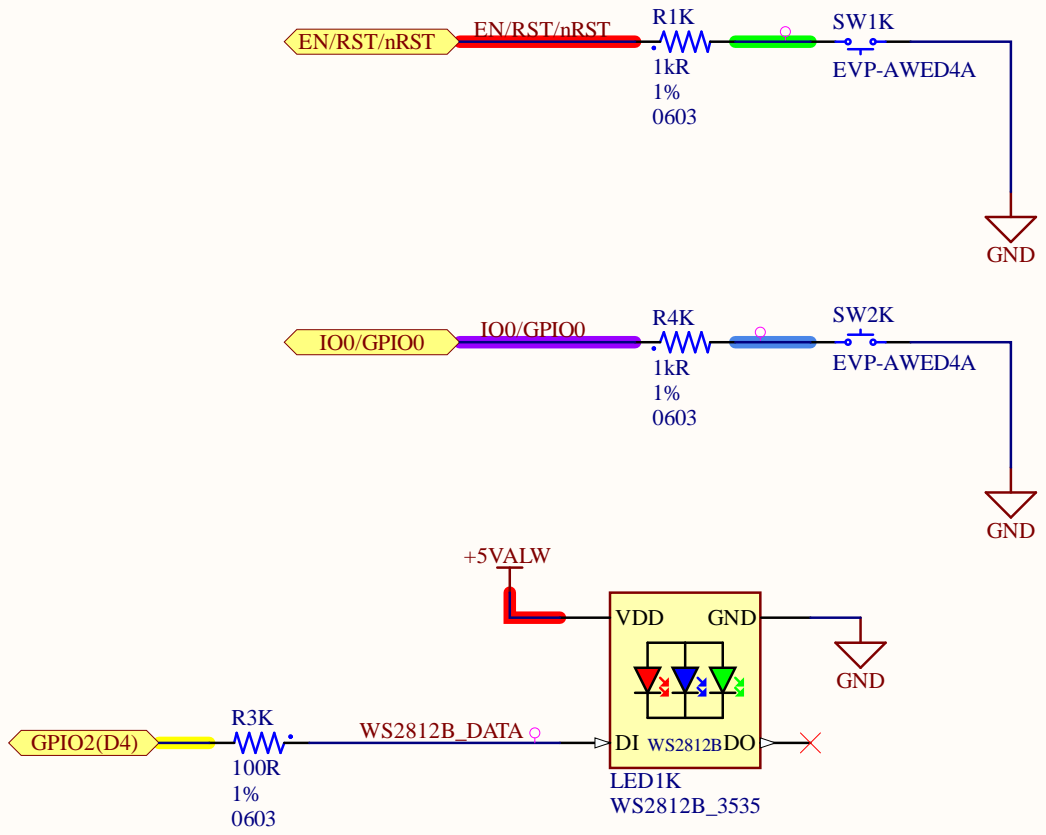
[picture p28: page 5]

File: C:\Users\desktop\Documents\Project Files\Altium\Projects\Project - Devlopment\ESP8266-Deskop_Power\5_Keys_And_Status.SchDoc

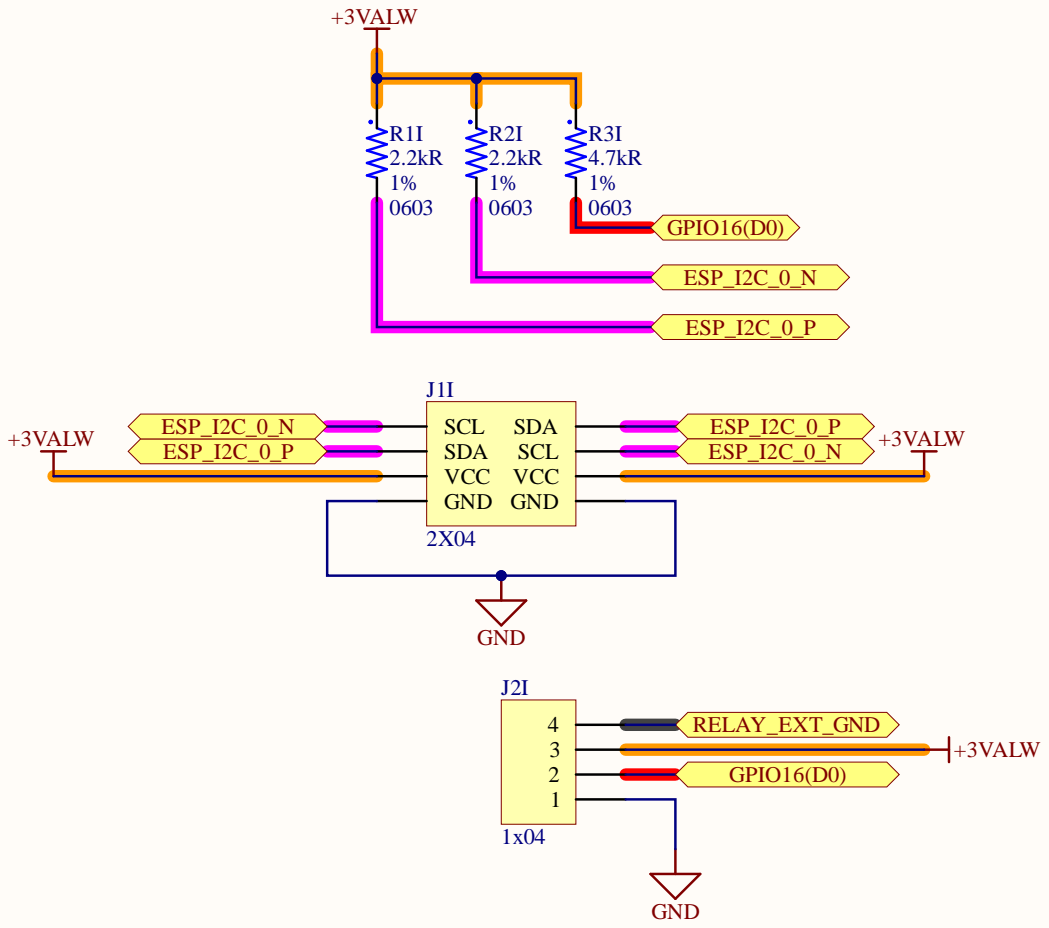
[picture p29: page 6]

File: C:\Users\desktop\Documents\Project Files\Altium\Projects\Project - Devlopment\ESP8266-Deskop_Power\6_I2C_Sensors.SchDoc

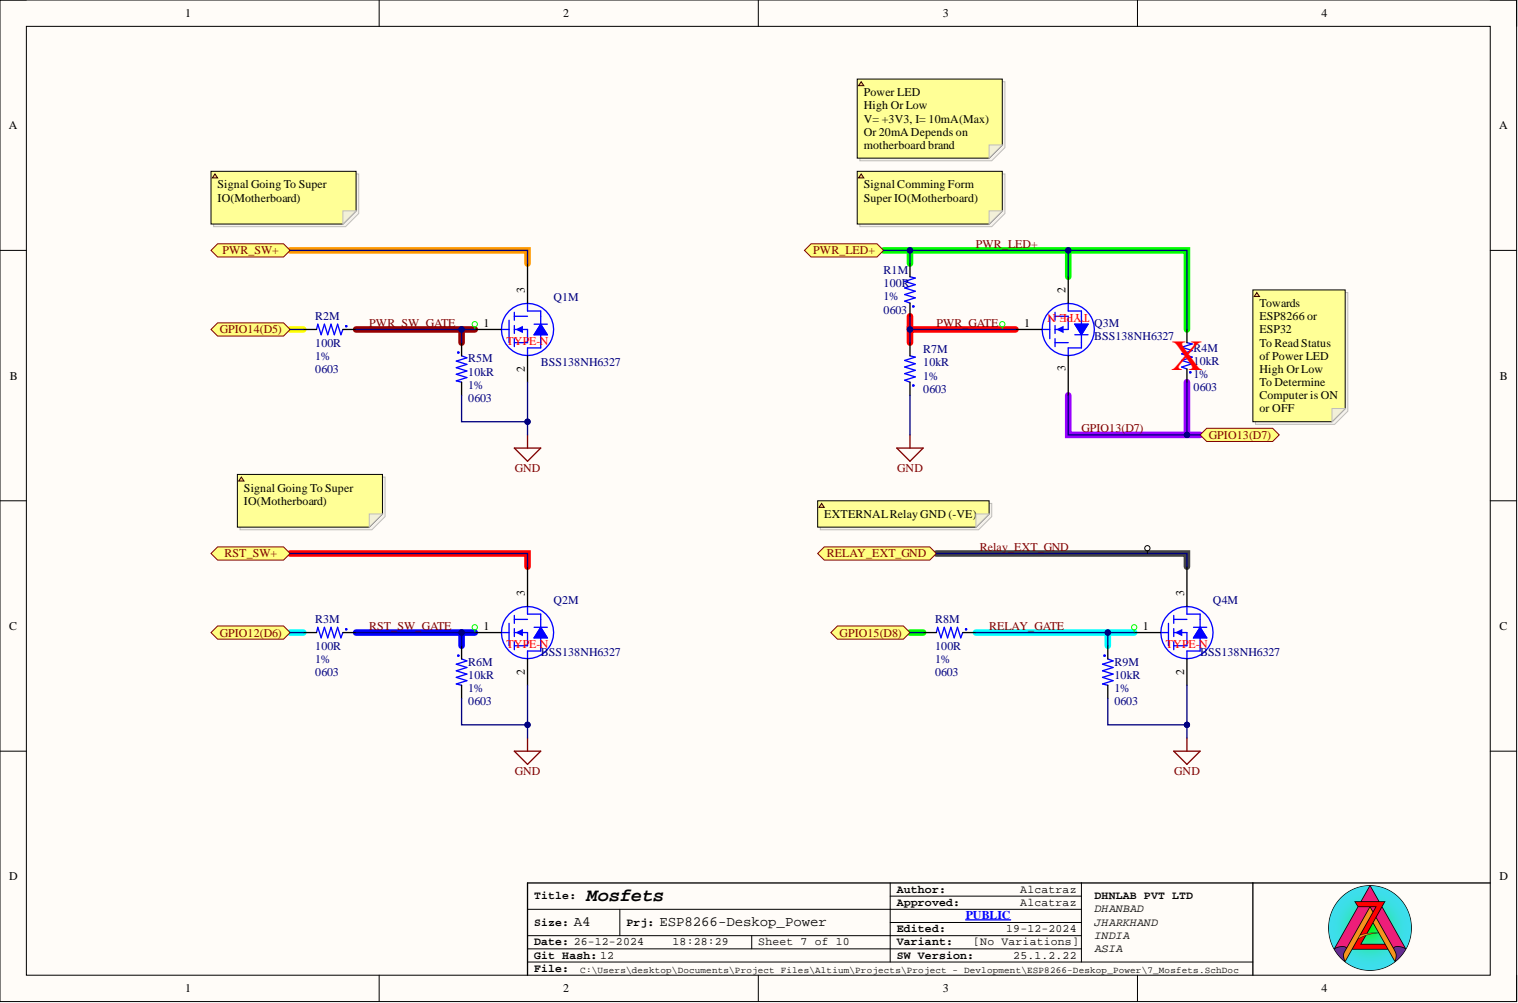
[picture p30: page 7]

Signal Going To Super
IO(Motherboard)

File: C:\Users\desktop\Documents\Project Files\Altium\Projects\Project - Devlopment\ESP8266-Deskop_Power\7_Mosfets.SchDoc

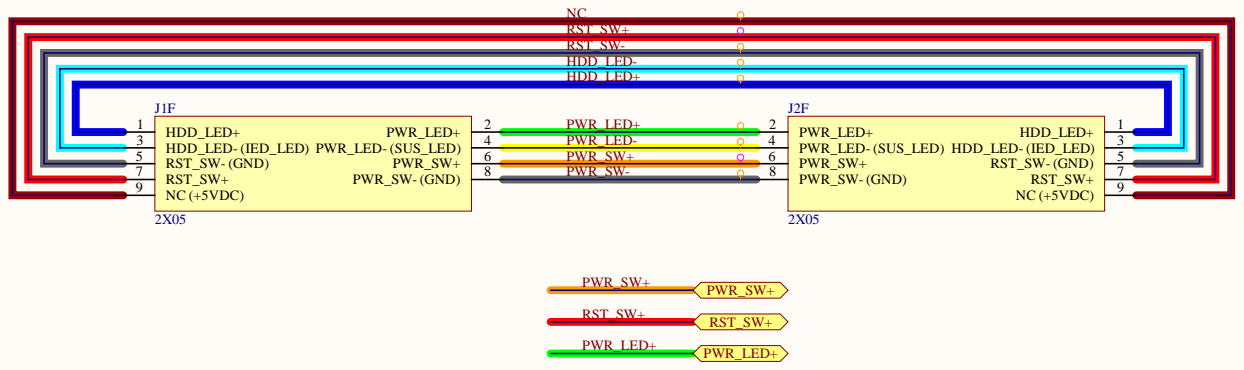
[picture p31: page 8]

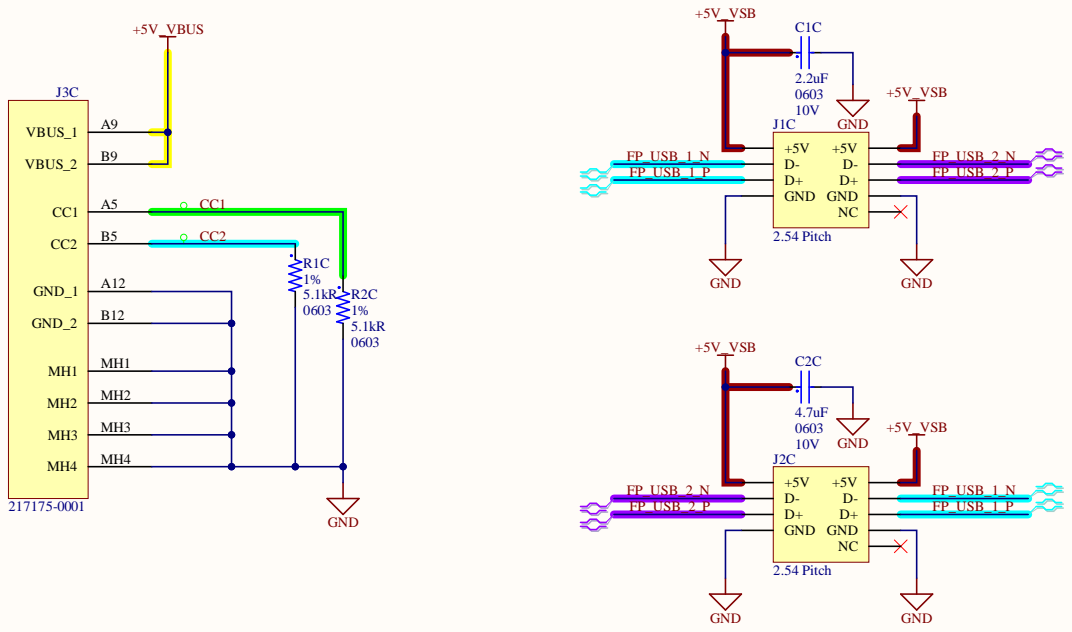
[picture p32: page 9]

Front Pannel USB Con

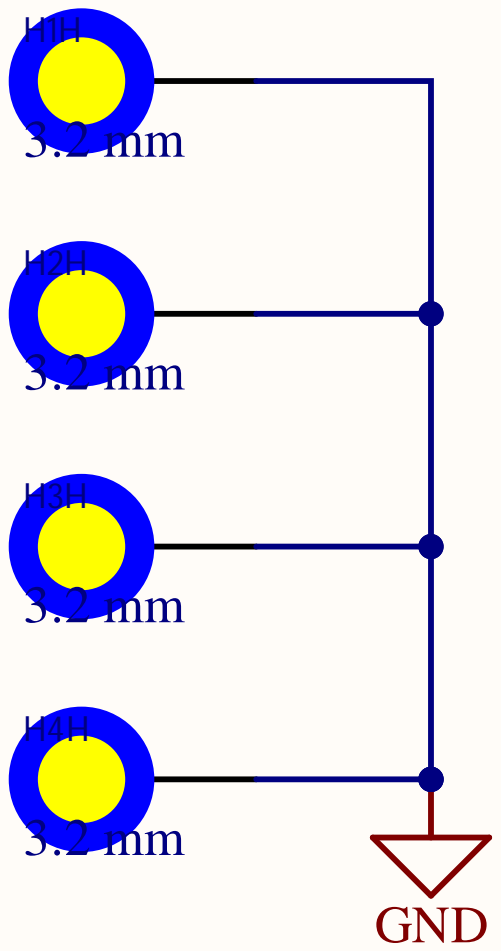
[picture p33: page 10]

File: C:\Users\desktop\Documents\Project Files\Altium\Projects\Project - Devlopment\ESP8266-Deskop_Power\10_MountingHoles.SchDoc
