bantybanty/ESP8266-Deskop_Power/Project Outputs for ESP8266-Deskop_Power/Full Documentation/PCB Print/Drill Drawing/Guides.PDF

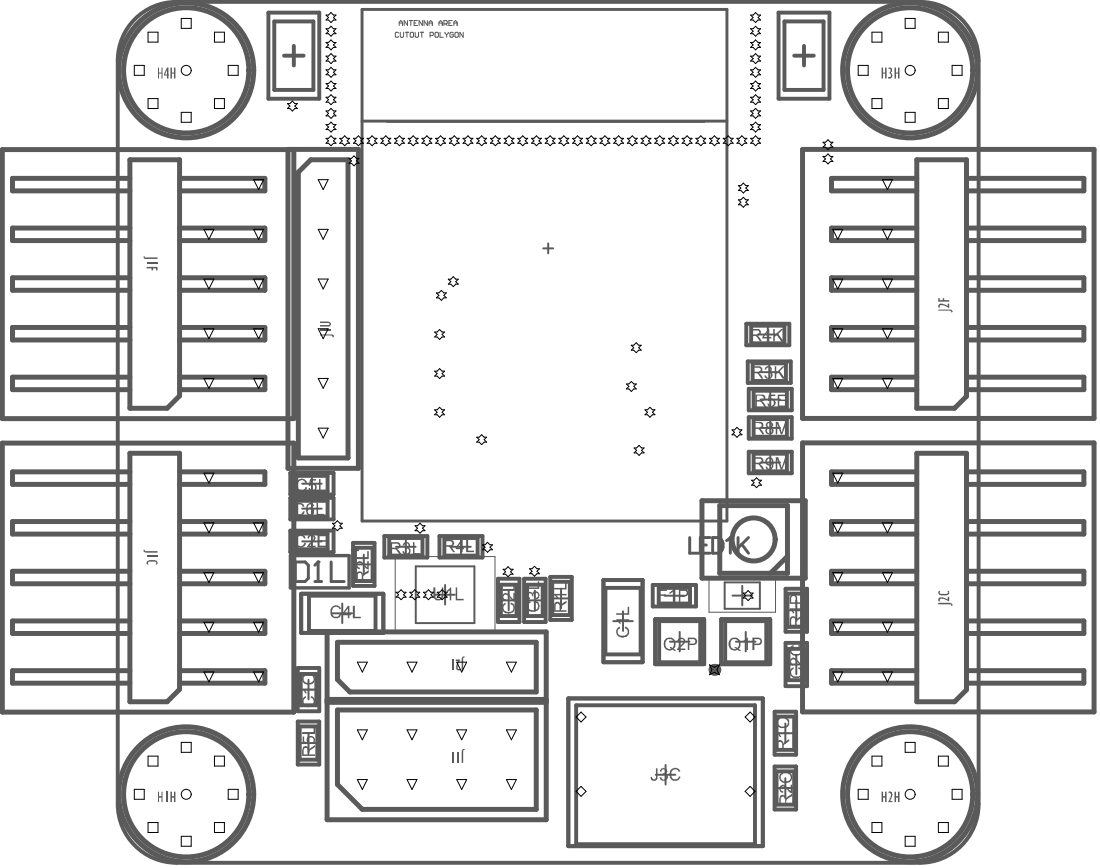
[picture p34: page 1]

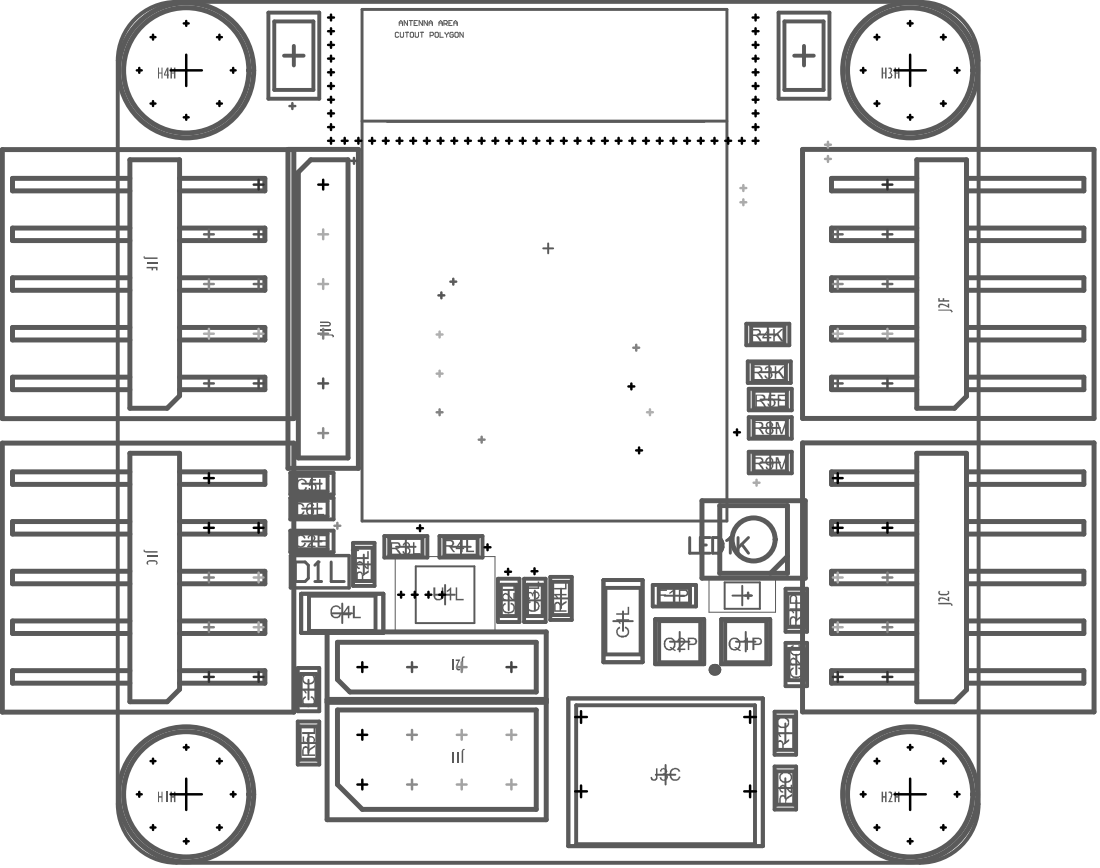
[picture p35: page 2]
