bantybanty/ESP8266-Deskop_Power/(list of files, drawings)

Other design files:
1_Power_Path.SchDoc
2_LDO.SchDoc
3_ESP8266_Core.SchDoc
4_UART.SchDoc
5_Keys_And_Status.SchDoc
6_I2C_Sensors.SchDoc
7_Mosfets.SchDoc
8_Front_Pannel_Con.SchDoc
9_Front_Pannel_USB_Con.SchDoc
10_MountingHoles.SchDoc
ESP8266-Deskop_Power.PrjPcb
