bantybanty/ESP8266-Deskop_Power/(commit log)

2024-12-06 Files added
    [10_MountingHoles.SchDoc, 1_Power_Path.SchDoc, 2_LDO.SchDoc, 3_ESP8266_Core.SchDoc, 4_USB_TO_UART.SchDoc, 5_Keys.SchDoc, 6_I2C_Sensors.SchDoc, 7_Mosfets.SchDoc]
2024-12-26 Pcb Re-done
    [3_ESP8266_Core.SchDoc, 4_USB_TO_UART.SchDoc, 5_Keys.SchDoc, Bill of Materials-ESP8266-Deskop_Power.xlsx, Component Cross Reference Report-ESP8266-Deskop_Power.xlsx, ESP8266-Deskop_Power.CSV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]
